spyren/Mecrisp-Cube/sdcard/man/img/calculator-header-150.jpg

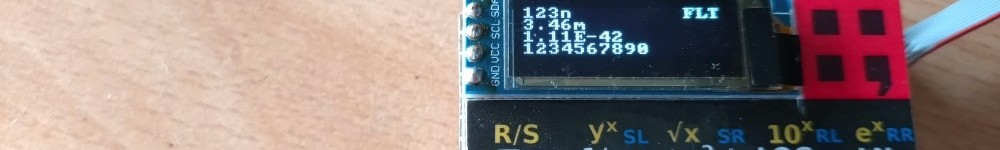
sdcard/man/img/calculator-header-150.jpg
