spyren/Mecrisp-Cube/sdcard/man/img/charger.jpg

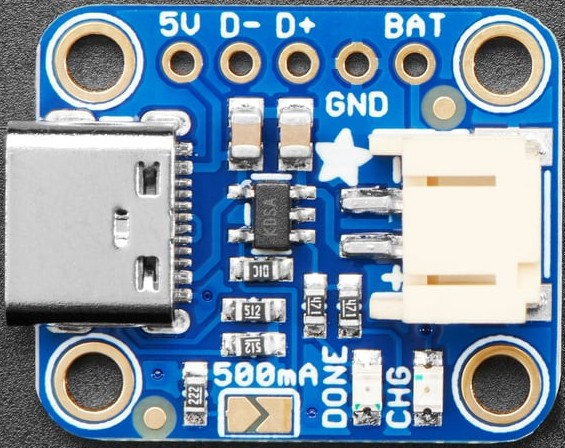
sdcard/man/img/charger.jpg
