spyren/Mecrisp-Cube/sdcard/man/img/display.jpg

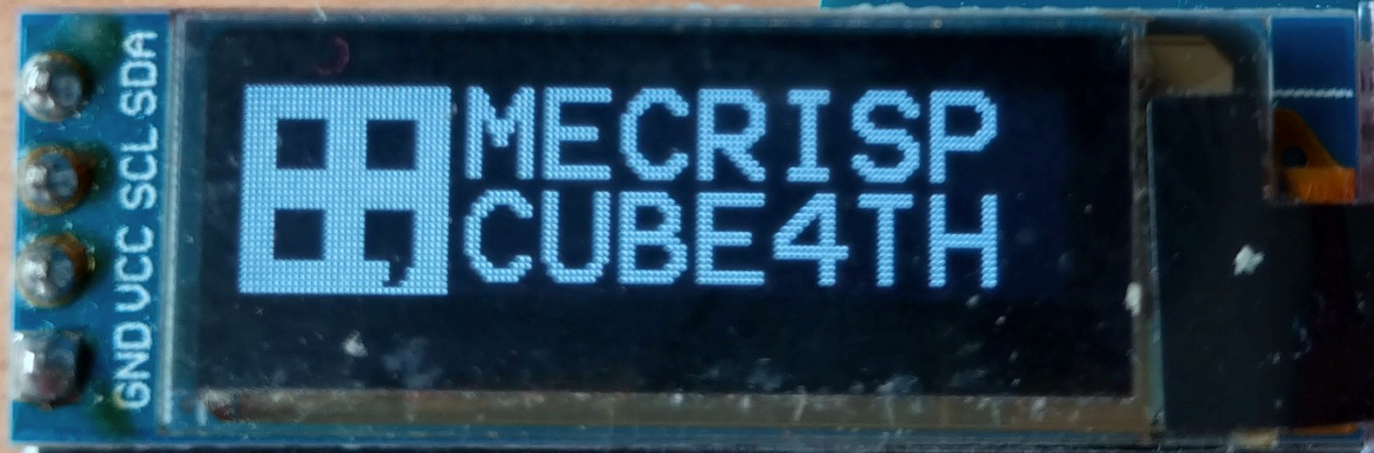
sdcard/man/img/display.jpg
