spyren/Mecrisp-Cube/sdcard/man/img/dongle.png

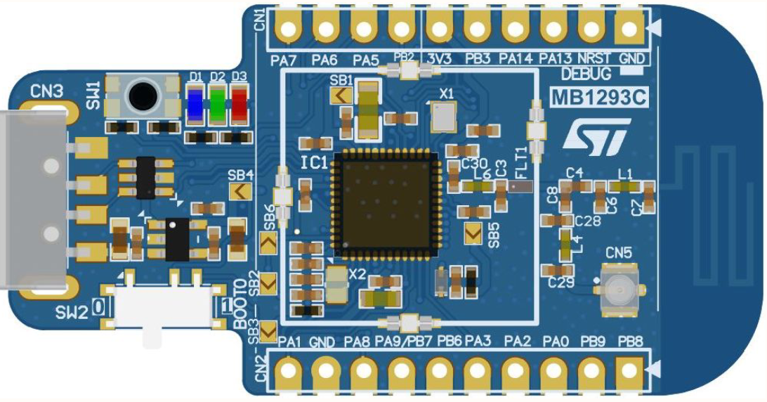
sdcard/man/img/dongle.png
