spyren/Mecrisp-Cube/sdcard/man/img/flipper-header.jpg

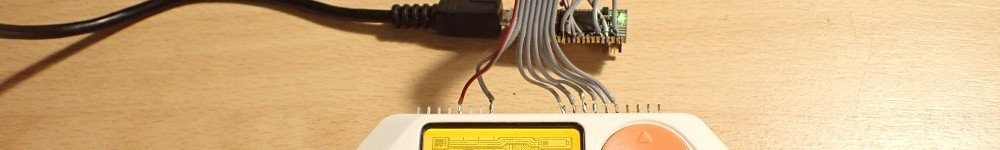
sdcard/man/img/flipper-header.jpg
