spyren/Mecrisp-Cube/sdcard/man/img/flipper-stlink-2.jpg

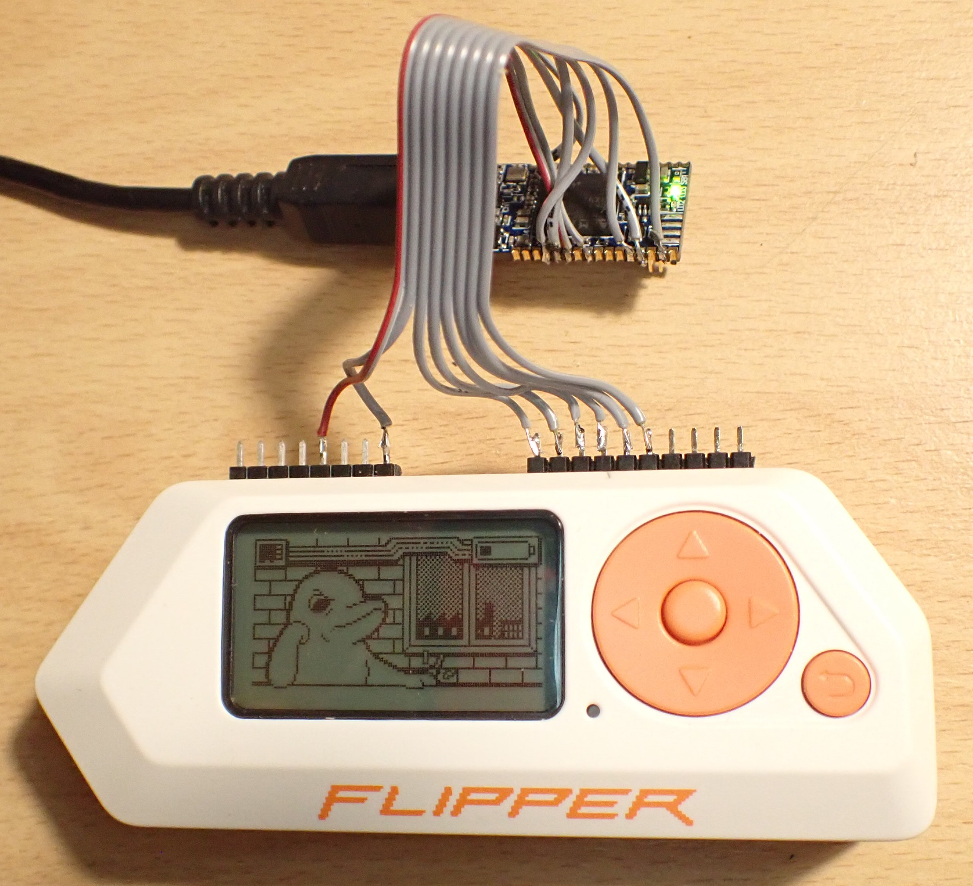
sdcard/man/img/flipper-stlink-2.jpg
