spyren/Mecrisp-Cube/sdcard/man/img/flipper-stlink.jpg

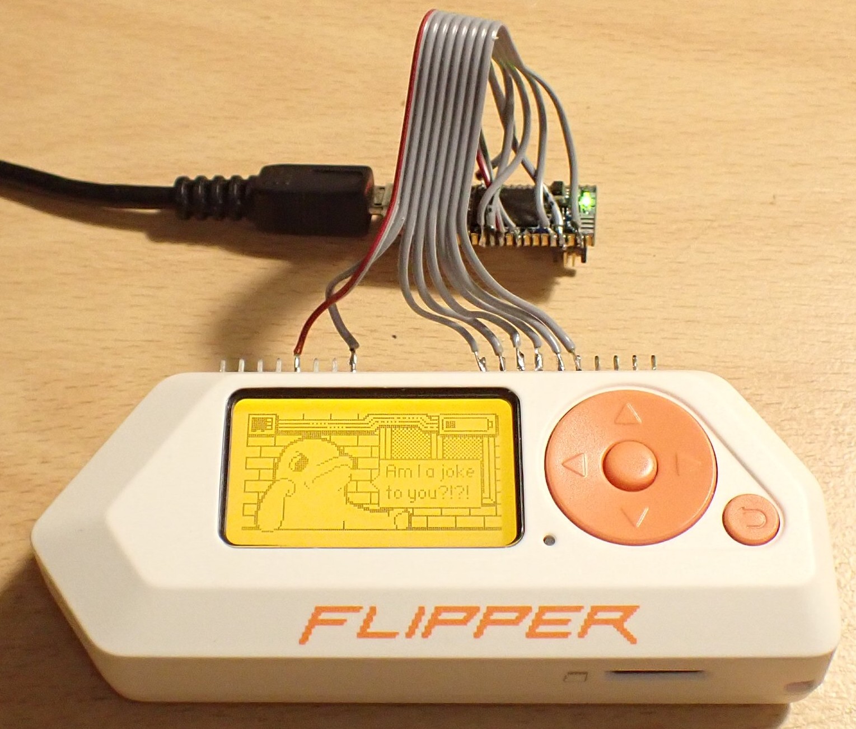
sdcard/man/img/flipper-stlink.jpg
