spyren/Mecrisp-Cube/sdcard/man/img/mecrisp-cube-f4.jpg

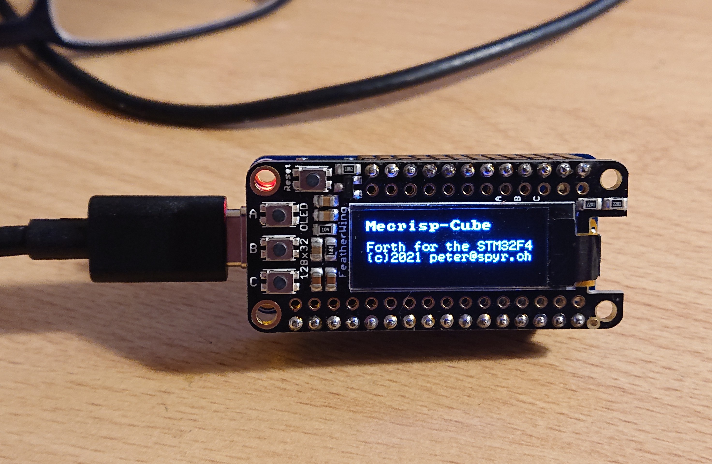
sdcard/man/img/mecrisp-cube-f4.jpg
