spyren/Mecrisp-Cube/sdcard/man/img/security.png

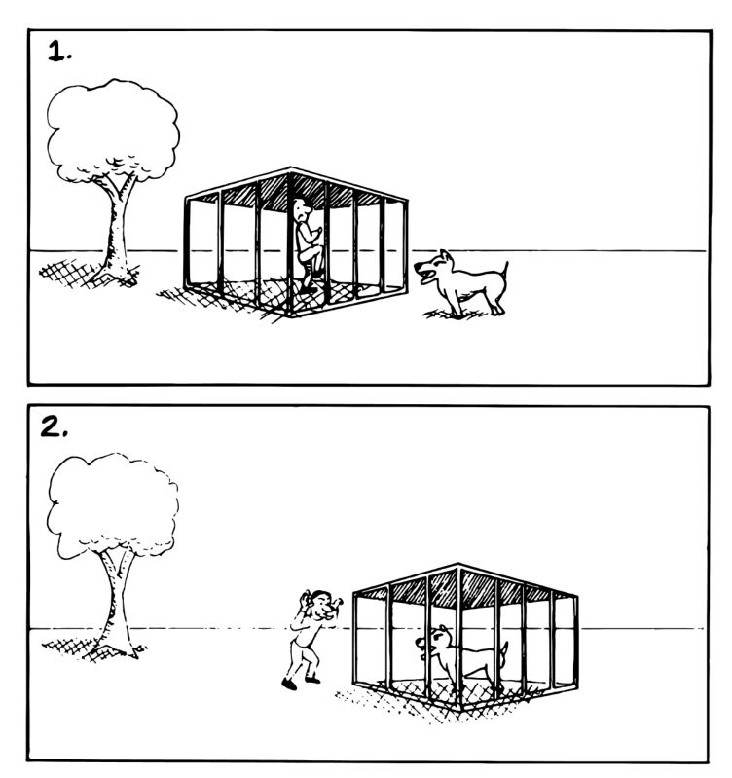
sdcard/man/img/security.png
