spyren/Mecrisp-Cube/sdcard/man/kicad/kicad.kicad_sch

## KiCad design sdcard/man/kicad/kicad.kicad_sch (2024-06-25)

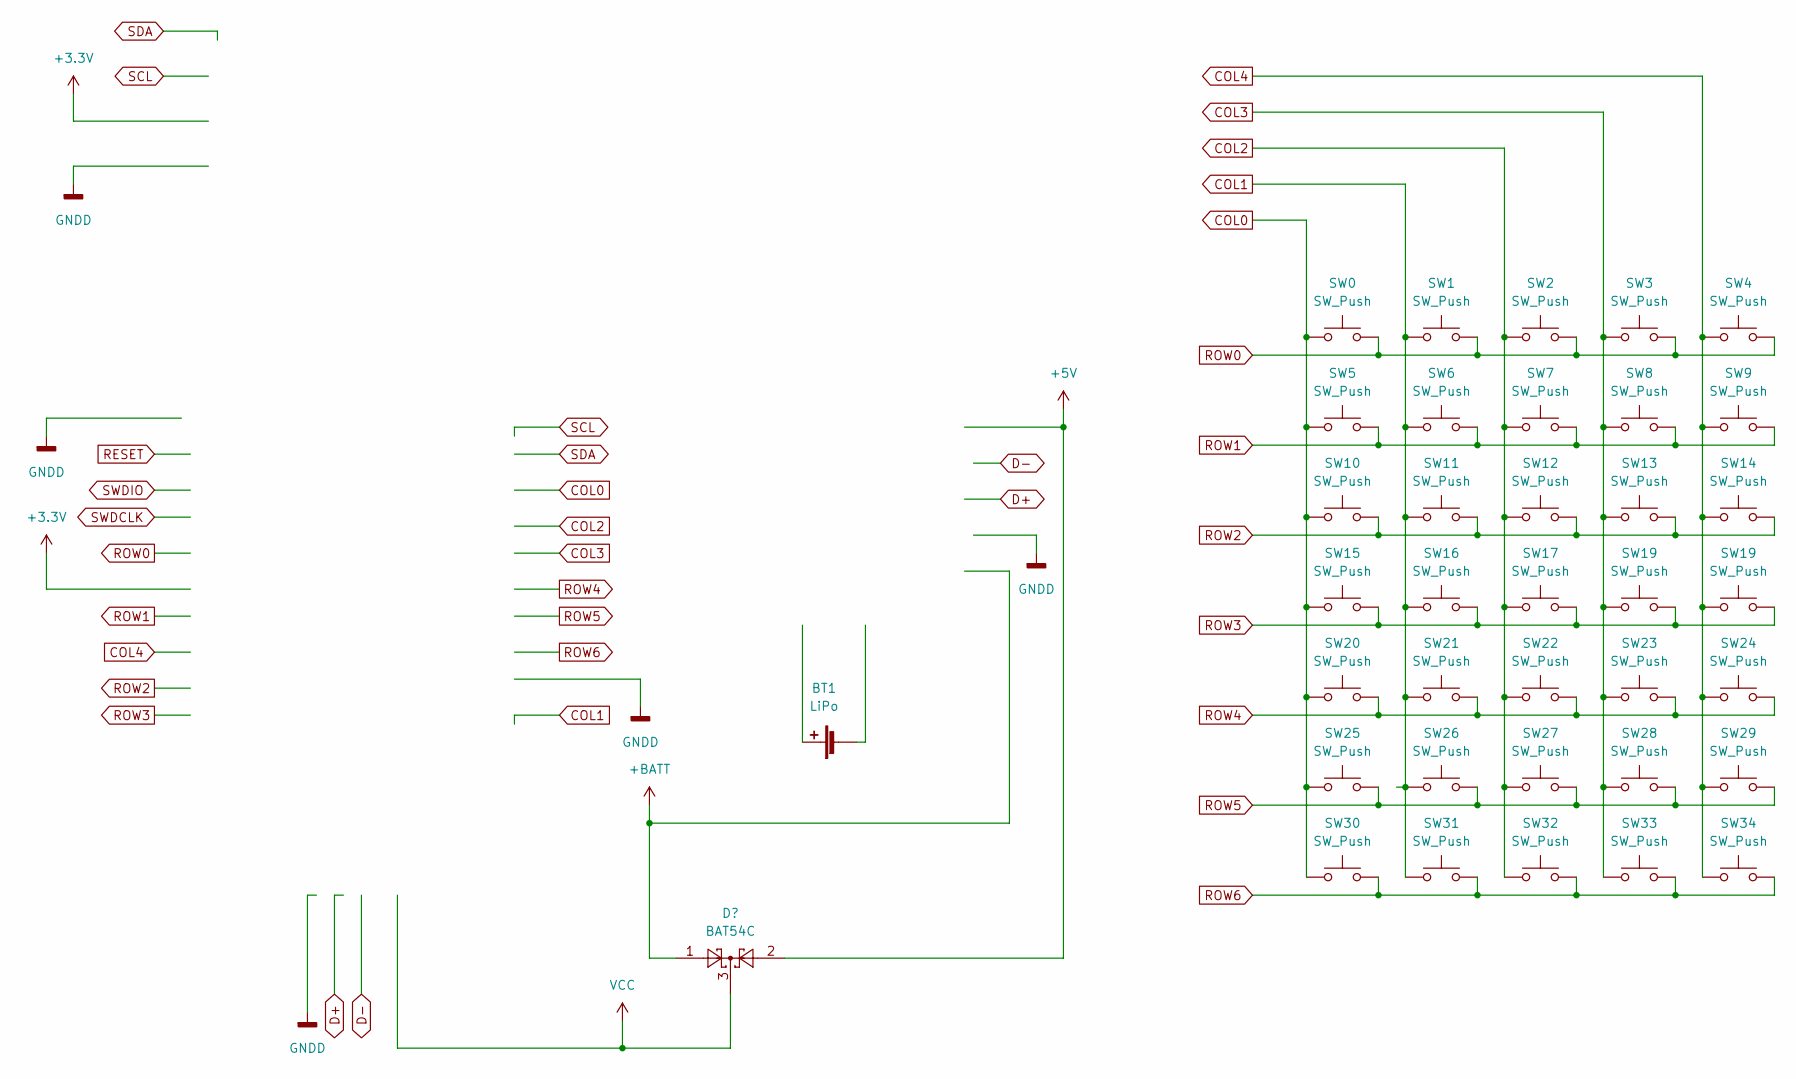
[picture p48: schematic kicad.kicad_sch]

Parts:
BT1: LiPo
SW0, SW1, SW2, SW3, SW4, SW5, SW6, SW7, SW8, SW9, SW10, SW11, SW12, SW13, SW14, SW15, SW16, SW17, SW19, SW20, SW21, SW22, SW23, SW24, SW25, SW26, SW27, SW28, SW29, SW30, SW31, SW32, SW33, SW34: SW_Push

Connections:
COL0: SW0.1, SW5.1, SW10.1, SW15.1, SW20.1, SW25.1, SW30.1
COL1: SW1.1, SW6.1, SW11.1, SW16.1, SW21.1, SW26.1, SW31.1
COL2: SW2.1, SW7.1, SW12.1, SW17.1, SW22.1, SW27.1, SW32.1
COL3: SW3.1, SW8.1, SW13.1, SW19.1, SW23.1, SW28.1, SW33.1
COL4: SW4.1, SW9.1, SW14.1, SW19.1, SW24.1, SW29.1, SW34.1
ROW0: SW0.2, SW1.2, SW2.2, SW3.2, SW4.2
ROW1: SW5.2, SW6.2, SW7.2, SW8.2, SW9.2
ROW2: SW10.2, SW11.2, SW12.2, SW13.2, SW14.2
ROW3: SW15.2, SW16.2, SW17.2, SW19.2
ROW4: SW20.2, SW21.2, SW22.2, SW23.2, SW24.2
ROW5: SW25.2, SW26.2, SW27.2, SW28.2, SW29.2
ROW6: SW30.2, SW31.2, SW32.2, SW33.2, SW34.2
