spyren/Mecrisp-Cube/MecrispCube.ioc

Mcu.UserName=STM32WB55RGVx
PA0.GPIO_Label=A3
PA0.Signal=SharedAnalog_PA0
PA1.GPIO_Label=A2
PA1.Signal=S_TIM2_CH2
PA10.GPIO_Label=D3
PA10.Signal=S_TIM1_CH3
PA11.Signal=USB_DM
PA12.Signal=USB_DP
PA13.GPIO_Label=JTMS
PA13.Signal=SYS_JTMS-SWDIO
PA14.GPIO_Label=JTCK
PA14.Signal=SYS_JTCK-SWCLK
PA15.GPIO_Label=D5
PA15.Signal=S_TIM2_CH1
PA2.GPIO_Label=D1
PA2.Signal=S_TIM2_CH3
PA3.GPIO_Label=D0
PA3.Signal=S_TIM2_CH4
PA4.GPIO_Label=D10
PA4.Signal=SharedStack_PA4
PA5.GPIO_Label=D13
PA5.Signal=SPI1_SCK
PA6.GPIO_Label=D12
PA6.Signal=SPI1_MISO
PA7.GPIO_Label=D11
PA7.Signal=SPI1_MOSI
PA8.GPIO_Label=D6
PA8.Signal=S_TIM1_CH1
PA9.GPIO_Label=D9
PA9.Signal=S_TIM1_CH2
PB0.GPIO_Label=LD2 [Green Led]
PB0.Signal=GPIO_Output
PB1.GPIO_Label=LD3 [Red Led]
PB1.Signal=GPIO_Output
PB2.GPIO_Label=DONGLE_SPI_CS
PB2.Signal=GPIO_Output
PB3.GPIO_Label=JTDO
PB3.Signal=SYS_JTDO-SWO
PB5.GPIO_Label=LD1 [Blue Led]
PB5.Signal=GPIO_Output
PB6.GPIO_Label=STLINK_RX
PB6.Signal=USART1_TX
PB7.GPIO_Label=STLINK_TX
PB7.Signal=USART1_RX
PB8.GPIO_Label=D15
PB8.Signal=SharedStack_PB8
PB9.GPIO_Label=D14
PB9.Signal=SharedStack_PB9
PC0.GPIO_Label=A0
PC0.Signal=SharedAnalog_PC0
PC1.GPIO_Label=A1
PC1.Signal=SharedAnalog_PC1
PC10.GPIO_Label=D4
PC10.Signal=SharedStack_PC10
PC12.GPIO_Label=D8
PC12.Signal=GPIO_Input
PC13.GPIO_Label=D7
PC13.Signal=SharedStack_PC13
PC14-OSC32_IN.Signal=RCC_OSC32_IN
PC15-OSC32_OUT.Signal=RCC_OSC32_OUT
PC2.GPIO_Label=A5
PC2.Signal=SharedAnalog_PC2
PC3.GPIO_Label=A4
PC3.Signal=SharedAnalog_PC3
PC4.GPIO_Label=B1 [Push Button]
PC4.Signal=GPIO_Input
PC6.GPIO_Label=D2
PC6.Signal=SharedStack_PC6
PD0.GPIO_Label=B2 [Push Button]
PD0.Signal=GPIO_Input
PD1.GPIO_Label=B3 [Push Button]
PD1.Signal=GPIO_Input
