spyren/Mecrisp-Cube/Core/Src/stm32wbxx_it.c

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

/* Includes ------------------------------------------------------------------*/
#include "main.h"
#include "stm32wbxx_it.h"
/* USER CODE BEGIN Includes */
#include "myassert.h"
/* USER CODE END Includes */

/* External variables --------------------------------------------------------*/
extern ADC_HandleTypeDef hadc1;
extern DMA_HandleTypeDef hdma_i2c1_rx;
extern DMA_HandleTypeDef hdma_i2c1_tx;
extern I2C_HandleTypeDef hi2c1;
extern IPCC_HandleTypeDef hipcc;
extern RTC_HandleTypeDef hrtc;
extern DMA_HandleTypeDef hdma_spi1_rx;
extern DMA_HandleTypeDef hdma_spi1_tx;
extern SPI_HandleTypeDef hspi1;
extern TIM_HandleTypeDef htim1;
extern TIM_HandleTypeDef htim2;
extern UART_HandleTypeDef huart1;
extern WWDG_HandleTypeDef hwwdg;
extern TIM_HandleTypeDef htim17;

/******************************************************************************/
/*           Cortex Processor Interruption and Exception Handlers          */
/******************************************************************************/
/**
  * @brief This function handles Non maskable interrupt.
  */
void NMI_Handler(void)
{
  /* USER CODE BEGIN NonMaskableInt_IRQn 0 */
	  while (1) {

	  }

  /* USER CODE END NonMaskableInt_IRQn 0 */
}

/**
  * @brief This function handles Hard fault interrupt.
  */
void HardFault_Handler(void)
{
  /* USER CODE BEGIN HardFault_IRQn 0 */
/*
    __asm volatile
    (
        " tst lr, #4                                                \n"
        " ite eq                                                    \n"
        " mrseq r0, msp                                             \n"
        " mrsne r0, psp                                             \n"
        " ldr r1, [r0, #24]                                         \n"
        " ldr r2, handler2_address_const                            \n"
        " bx r2                                                     \n"
        " handler2_address_const: .word prvGetRegistersFromStack    \n"
    );
*/

	// christmas tree
	HAL_GPIO_WritePin(LD3_GPIO_Port, LD1_Pin, GPIO_PIN_SET);
	HAL_GPIO_WritePin(LD3_GPIO_Port, LD2_Pin, GPIO_PIN_SET);
	HAL_GPIO_WritePin(LD3_GPIO_Port, LD3_Pin, GPIO_PIN_SET);

	ASSERT_fatal(0, ASSERT_HARD_FAULT, SCB->CFSR);
  /* USER CODE END HardFault_IRQn 0 */
  while (1)
  {
  }
}

/**
  * @brief This function handles Memory management fault.
  */
void MemManage_Handler(void)
{
  /* USER CODE BEGIN MemoryManagement_IRQn 0 */
	ASSERT_fatal(0, ASSERT_MEM_MANAGE_FAULT, SCB->CFSR);

  /* USER CODE END MemoryManagement_IRQn 0 */
  while (1)
  {
  }
}

/**
  * @brief This function handles Prefetch fault, memory access fault.
  */
void BusFault_Handler(void)
{
  /* USER CODE BEGIN BusFault_IRQn 0 */
	ASSERT_fatal(0, ASSERT_BUS_FAULT, SCB->CFSR);

  /* USER CODE END BusFault_IRQn 0 */
  while (1)
  {
  }
}

/**
  * @brief This function handles Undefined instruction or illegal state.
  */
void UsageFault_Handler(void)
{
  /* USER CODE BEGIN UsageFault_IRQn 0 */

	/* Configurable Fault Status Registers */
	ASSERT_fatal(0, ASSERT_USAGE_FAULT, SCB->CFSR);

  /* USER CODE END UsageFault_IRQn 0 */
  while (1)
  {
  }
}

/**
  * @brief This function handles Debug monitor.
  */
void DebugMon_Handler(void)
{
}

/******************************************************************************/
/* STM32WBxx Peripheral Interrupt Handlers                                    */
/* Add here the Interrupt Handlers for the used peripherals.                  */
/* For the available peripheral interrupt handler names,                      */
/* please refer to the startup file (startup_stm32wbxx.s).                    */
/******************************************************************************/

/**
  * @brief This function handles Window watchdog interrupt.
  */
void WWDG_IRQHandler(void)
{
  HAL_WWDG_IRQHandler(&hwwdg);
}

/**
  * @brief This function handles RTC wake-up interrupt through EXTI line 19.
  */
void RTC_WKUP_IRQHandler(void)
{
  /* USER CODE BEGIN RTC_WKUP_IRQn 0 */
  HW_TS_RTC_Wakeup_Handler();
  /* USER CODE END RTC_WKUP_IRQn 0 */
  HAL_RTCEx_WakeUpTimerIRQHandler(&hrtc);
}

/**
  * @brief This function handles Flash global interrupt.
  */
void FLASH_IRQHandler(void)
{
  HAL_FLASH_IRQHandler();
}

#if BUTTON == 1
/**
  * @brief This function handles EXTI line0 interrupt.
  */
void EXTI0_IRQHandler(void)
{
  HAL_GPIO_EXTI_IRQHandler(GPIO_PIN_0);
}

/**
  * @brief This function handles EXTI line1 interrupt.
  */
void EXTI1_IRQHandler(void)
{
  HAL_GPIO_EXTI_IRQHandler(GPIO_PIN_1);
}

/**
  * @brief This function handles EXTI line2 interrupt.
  */
void EXTI2_IRQHandler(void)
{
  HAL_GPIO_EXTI_IRQHandler(GPIO_PIN_2);
}

/**
  * @brief This function handles EXTI line3 interrupt.
  */
void EXTI3_IRQHandler(void)
{
  HAL_GPIO_EXTI_IRQHandler(GPIO_PIN_3);
}
#endif

/**
  * @brief This function handles EXTI line4 interrupt.
  */
void EXTI4_IRQHandler(void)
{
  HAL_GPIO_EXTI_IRQHandler(GPIO_PIN_4);
}

/**
  * @brief This function handles EXTI line[9:5] interrupts.
  */
void EXTI9_5_IRQHandler(void)
{
#if BUTTON == 1
  HAL_GPIO_EXTI_IRQHandler(GPIO_PIN_5);
#else
  HAL_GPIO_EXTI_IRQHandler(GPIO_PIN_6);
#endif
}

/**
  * @brief This function handles DMA1 channel1 global interrupt.
  */
void DMA1_Channel1_IRQHandler(void)
{
  HAL_DMA_IRQHandler(&hdma_spi1_rx);
}

/**
  * @brief This function handles DMA1 channel2 global interrupt.
  */
void DMA1_Channel2_IRQHandler(void)
{
  HAL_DMA_IRQHandler(&hdma_spi1_tx);
}

/**
  * @brief This function handles DMA1 channel3 global interrupt.
  */
void DMA1_Channel3_IRQHandler(void)
{
  HAL_DMA_IRQHandler(&hdma_i2c1_rx);
}

/**
  * @brief This function handles DMA1 channel4 global interrupt.
  */
void DMA1_Channel4_IRQHandler(void)
{
  HAL_DMA_IRQHandler(&hdma_i2c1_tx);
}

/**
  * @brief This function handles ADC1 global interrupt.
  */
void ADC1_IRQHandler(void)
{
  HAL_ADC_IRQHandler(&hadc1);
}

/**
  * @brief This function handles TIM1 trigger and commutation interrupts and TIM17 global interrupt.
  */
void TIM1_TRG_COM_TIM17_IRQHandler(void)
{
  HAL_TIM_IRQHandler(&htim1);
  HAL_TIM_IRQHandler(&htim17);
}

/**
  * @brief This function handles TIM2 global interrupt.
  */
void TIM2_IRQHandler(void)
{
  HAL_TIM_IRQHandler(&htim2);
}

/**
  * @brief This function handles I2C1 event interrupt.
  */
void I2C1_EV_IRQHandler(void)
{
  HAL_I2C_EV_IRQHandler(&hi2c1);
}

/**
  * @brief This function handles I2C1 error interrupt.
  */
void I2C1_ER_IRQHandler(void)
{
  HAL_I2C_ER_IRQHandler(&hi2c1);
}

/**
  * @brief This function handles SPI1 global interrupt.
  */
void SPI1_IRQHandler(void)
{
  HAL_SPI_IRQHandler(&hspi1);
}

/**
  * @brief This function handles USART1 global interrupt.
  */
void USART1_IRQHandler(void)
{
  HAL_UART_IRQHandler(&huart1);
}

/**
  * @brief This function handles EXTI line[15:10] interrupts.
  */
void EXTI15_10_IRQHandler(void)
{
  HAL_GPIO_EXTI_IRQHandler(GPIO_PIN_10);
  HAL_GPIO_EXTI_IRQHandler(GPIO_PIN_13);
}

/**
  * @brief This function handles RTC A and B alarm interrupt through EXTI line 17.
  */
void RTC_Alarm_IRQHandler(void)
{
  HAL_RTC_AlarmIRQHandler(&hrtc);
}

/**
  * @brief This function handles IPCC RX occupied interrupt.
  */
void IPCC_C1_RX_IRQHandler(void)
{
  HAL_IPCC_RX_IRQHandler(&hipcc);
}

/**
  * @brief This function handles IPCC TX free interrupt.
  */
void IPCC_C1_TX_IRQHandler(void)
{
  HAL_IPCC_TX_IRQHandler(&hipcc);
}

/**
  * @brief This function handles HSEM global interrupt.
  */
void HSEM_IRQHandler(void)
{
  HAL_HSEM_IRQHandler();
}

/* USER CODE BEGIN 1 */

/*
void prvGetRegistersFromStack( uint32_t *pulFaultStackAddress )
{
// These are volatile to try and prevent the compiler/linker optimising them
//away as the variables never actually get used.  If the debugger won't show the
//values of the variables, make them global my moving their declaration outside
//of this function.
volatile uint32_t r0;
volatile uint32_t r1;
volatile uint32_t r2;
volatile uint32_t r3;
volatile uint32_t r12;
volatile uint32_t lr; // Link register.
volatile uint32_t pc; // Program counter.
volatile uint32_t psr;// Program status register.

    r0 = pulFaultStackAddress[ 0 ];
    r1 = pulFaultStackAddress[ 1 ];
    r2 = pulFaultStackAddress[ 2 ];
    r3 = pulFaultStackAddress[ 3 ];

    r12 = pulFaultStackAddress[ 4 ];
    lr = pulFaultStackAddress[ 5 ];
    pc = pulFaultStackAddress[ 6 ];
    psr = pulFaultStackAddress[ 7 ];

    // When the following line is hit, the variables contain the register values.
    for( ;; );
}
*/

/* USER CODE END 1 */
