spyren/Mecrisp-Cube/Forth/Inc/12x16_vertikal_LSB_1.h

/*
 * 8x16_vertikal_LSB_1.h
 *
 *  Created on: 02.01.2021
 *      Author: psi
 */

#ifndef INC_12X16_H_
#define INC_12X16_H_

const char font_12x16[256][24]={
		{0x00,0x00,0x00,0x00,0x00,0x00,0x00,0x00,0x00,0x00,0x00,0x00,0x00,0x00,0x00,0x00,0x00,0x00,0x00,0x00,0x00,0x00,0x00,0x00},	// 0x00
		{0x00,0x00,0xF0,0x03,0x0C,0x0C,0x02,0x10,0x32,0x11,0x31,0x22,0x01,0x22,0x31,0x22,0x32,0x11,0x02,0x10,0x0C,0x0C,0xF0,0x03},	// 0x01
		{0x00,0x00,0xF0,0x03,0xFC,0x0F,0xFE,0x1F,0xCE,0x1E,0xCF,0x3D,0xFF,0x3D,0xCF,0x3D,0xCE,0x1E,0xFE,0x1F,0xFC,0x0F,0xF0,0x03},	// 0x02
		{0x00,0x00,0x00,0x00,0xF0,0x00,0xF8,0x01,0xF8,0x03,0xF0,0x07,0xE0,0x0F,0xF0,0x07,0xF8,0x03,0xF8,0x01,0xF0,0x00,0x00,0x00},	// 0x03
		{0x00,0x00,0x00,0x00,0x80,0x00,0xC0,0x01,0xE0,0x03,0xF0,0x07,0xF8,0x0F,0xF0,0x07,0xE0,0x03,0xC0,0x01,0x80,0x00,0x00,0x00},	// 0x04
		{0x00,0x00,0x80,0x03,0xC0,0x07,0xC0,0x07,0xB8,0x13,0xFC,0x1B,0xFC,0x1F,0xFC,0x1B,0xB8,0x13,0xC0,0x07,0xC0,0x07,0x80,0x03},	// 0x05
		{0x00,0x00,0x00,0x00,0x80,0x03,0xC0,0x07,0xE0,0x17,0xF0,0x1B,0xFC,0x1F,0xF0,0x1B,0xE0,0x17,0xC0,0x07,0x80,0x03,0x00,0x00},	// 0x06
		{0x00,0x00,0x00,0x00,0x00,0x00,0x00,0x00,0x00,0x00,0x00,0x00,0x00,0x00,0x00,0x00,0x00,0x00,0x00,0x00,0x00,0x00,0x00,0x00},	// 0x07
		{0x00,0x00,0x00,0x00,0x00,0x00,0x00,0x00,0x00,0x00,0x00,0x00,0x00,0x00,0x00,0x00,0x00,0x00,0x00,0x00,0x00,0x00,0x00,0x00},	// 0x08
		{0x00,0x00,0x00,0x00,0x00,0x00,0x00,0x00,0x00,0x00,0x00,0x00,0x00,0x00,0x00,0x00,0x00,0x00,0x00,0x00,0x00,0x00,0x00,0x00},	// 0x09
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
		{0x00,0x00,0x00,0x00,0x00,0x00,0x00,0x00,0x27,0x00,0x3F,0x00,0x1F,0x00,0x00,0x00,0x00,0x00,0x00,0x00,0x00,0x00,0x00,0x00},	// 0x27
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
		};

#endif /* INC_12X16_H_ */
