spyren/Mecrisp-Cube/Forth/Inc/8x8_vertikal_LSB_1.h

/*
 * 8x8_vertikal_LSB_1.h
 *
 *  Created on: 02.01.2021
 *      Author: psi
 */

#ifndef INC_8X8_H_
#define INC_8X8_H_

const char font_8x8[256][8]={
		{0x00,0x00,0x00,0x00,0x00,0x00,0x00,0x00},	// 0x00
		{0x7E,0x81,0x95,0xB1,0xB1,0x95,0x81,0x7E},	// 0x01
		{0x7E,0xFF,0xEB,0xCF,0xCF,0xEB,0xFF,0x7E},	// 0x02
		{0x0E,0x1F,0x3F,0x7E,0x3F,0x1F,0x0E,0x00},	// 0x03
		{0x08,0x1C,0x3E,0x7F,0x3E,0x1C,0x08,0x00},	// 0x04
		{0x38,0x3A,0x9F,0xFF,0x9F,0x3A,0x38,0x00},	// 0x05
		{0x10,0x38,0xBC,0xFF,0xBC,0x38,0x10,0x00},	// 0x06
		{0x00,0x00,0x00,0x00,0x00,0x00,0x00,0x00},	// 0x07
		{0x00,0x00,0x00,0x00,0x00,0x00,0x00,0x00},	// 0x08
		{0x00,0x00,0x00,0x00,0x00,0x00,0x00,0x00},	// 0x09
		{0x00,0x00,0x00,0x00,0x00,0x00,0x00,0x00},	// 0x0A
		{0x70,0xF8,0x88,0x88,0xFD,0x7F,0x07,0x0F},	// 0x0B
		{0x00,0x4E,0x5F,0xF1,0xF1,0x5F,0x4E,0x00},	// 0x0C
		{0x00,0x00,0x00,0x00,0x00,0x00,0x00,0x00},	// 0x0D
		{0xC0,0xFF,0x7F,0x05,0x05,0x65,0x7F,0x3F},	// 0x0E
		{0x99,0x5A,0x3C,0xE7,0xE7,0x3C,0x5A,0x99},	// 0x0F
		{0x7F,0x3E,0x3E,0x1C,0x1C,0x08,0x08,0x00},	// 0x10
		{0x08,0x08,0x1C,0x1C,0x3E,0x3E,0x7F,0x00},	// 0x11
		{0x00,0x24,0x66,0xFF,0xFF,0x66,0x24,0x00},	// 0x12
		{0x00,0x5F,0x5F,0x00,0x00,0x5F,0x5F,0x00},	// 0x13
		{0x06,0x0F,0x09,0x7F,0x7F,0x01,0x7F,0x7F},	// 0x14
		{0xDA,0xBF,0xA5,0xA5,0xFD,0x59,0x03,0x02},	// 0x15
		{0x00,0x70,0x70,0x70,0x70,0x70,0x70,0x00},	// 0x16
		{0x80,0x94,0xB6,0xFF,0xFF,0xB6,0x94,0x80},	// 0x17
		{0x00,0x04,0x06,0x7F,0x7F,0x06,0x04,0x00},	// 0x18
		{0x00,0x10,0x30,0x7F,0x7F,0x30,0x10,0x00},	// 0x19
		{0x08,0x08,0x08,0x2A,0x3E,0x1C,0x08,0x00},	// 0x1A
		{0x08,0x1C,0x3E,0x2A,0x08,0x08,0x08,0x00},	// 0x1B
		{0x3C,0x3C,0x20,0x20,0x20,0x20,0x20,0x00},	// 0x1C
		{0x08,0x1C,0x3E,0x08,0x08,0x3E,0x1C,0x08},	// 0x1D
		{0x30,0x38,0x3C,0x3E,0x3E,0x3C,0x38,0x30},	// 0x1E
		{0x06,0x0E,0x1E,0x3E,0x3E,0x1E,0x0E,0x06},	// 0x1F
		{0x00,0x00,0x00,0x00,0x00,0x00,0x00,0x00},	// 0x20
		{0x00,0x06,0x5F,0x5F,0x06,0x00,0x00,0x00},	// 0x21
		{0x00,0x07,0x07,0x00,0x07,0x07,0x00,0x00},	// 0x22
		{0x14,0x7F,0x7F,0x14,0x7F,0x7F,0x14,0x00},	// 0x23
		{0x24,0x2E,0x6B,0x6B,0x3A,0x12,0x00,0x00},	// 0x24
		{0x46,0x66,0x30,0x18,0x0C,0x66,0x62,0x00},	// 0x25
		{0x30,0x7A,0x4F,0x5D,0x37,0x7A,0x48,0x00},	// 0x26
		{0x04,0x07,0x03,0x00,0x00,0x00,0x00,0x00},	// 0x27
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
		};

#endif /* INC_8X8_H_ */
