spyren/Mecrisp-Cube/tinyusb/bsp/family.c

/*
 * The MIT License (MIT)
 *
 * Copyright (c) 2022 Jerzy Kasenberg
 *
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
 * This file is part of the TinyUSB stack.
 */

#include "stm32wbxx_hal.h"
#include "bsp/board_api.h"
#include "board.h"
#include "stm32_lpm.h"

//--------------------------------------------------------------------+
// Forward USB interrupt events to TinyUSB IRQ Handler
//--------------------------------------------------------------------+
void USB_HP_IRQHandler(void)
{
  UTIL_LPM_SetStopMode(1U << CFG_LPM_USB, UTIL_LPM_DISABLE);
  tud_int_handler(0);
}

void USB_LP_IRQHandler(void)
{
  UTIL_LPM_SetStopMode(1U << CFG_LPM_USB, UTIL_LPM_DISABLE);
  tud_int_handler(0);
}

//--------------------------------------------------------------------+
// MACRO TYPEDEF CONSTANT ENUM
//--------------------------------------------------------------------+
UART_HandleTypeDef UartHandle;

void board_init(void)
{
	// see main.c
//  board_clock_init();

  // Enable All GPIOs clocks
  __HAL_RCC_GPIOA_CLK_ENABLE();
  __HAL_RCC_GPIOB_CLK_ENABLE();
  __HAL_RCC_GPIOC_CLK_ENABLE();
  __HAL_RCC_GPIOD_CLK_ENABLE();
  __HAL_RCC_GPIOE_CLK_ENABLE();

  UART_CLK_EN();

#if CFG_TUSB_OS == OPT_OS_NONE
  // 1ms tick timer
  SysTick_Config(SystemCoreClock / 1000);
#elif CFG_TUSB_OS == OPT_OS_FREERTOS
  // Explicitly disable systick to prevent its ISR runs before scheduler start
//  SysTick->CTRL &= ~1U;

  // If freeRTOS is used, IRQ priority is limit by max syscall ( smaller is higher )
  NVIC_SetPriority(USB_HP_IRQn, configLIBRARY_MAX_SYSCALL_INTERRUPT_PRIORITY);
  NVIC_SetPriority(USB_LP_IRQn, configLIBRARY_MAX_SYSCALL_INTERRUPT_PRIORITY);
#endif


  GPIO_InitTypeDef  GPIO_InitStruct;

#if 0
  // LED
  GPIO_InitStruct.Pin = LED_PIN;
  GPIO_InitStruct.Mode = GPIO_MODE_OUTPUT_PP;
  GPIO_InitStruct.Pull = GPIO_NOPULL;
  GPIO_InitStruct.Speed = GPIO_SPEED_FREQ_HIGH;
  HAL_GPIO_Init(LED_PORT, &GPIO_InitStruct);

#if 0
  // MCO configuration for System clock value verification PA8 will have SYSCLK / 2
  GPIO_InitStruct.Pin = 8;
  GPIO_InitStruct.Mode = GPIO_MODE_OUTPUT_PP;
  GPIO_InitStruct.Pull = GPIO_NOPULL;
  GPIO_InitStruct.Speed = GPIO_SPEED_FREQ_HIGH;
  GPIO_InitStruct.Alternate = GPIO_AF0_MCO;
  HAL_GPIO_Init(GPIOA, &GPIO_InitStruct);
  HAL_RCC_MCOConfig(RCC_MCO1, RCC_MCO1SOURCE_SYSCLK, RCC_MCODIV_2);
#endif

//  board_led_write(false);

  // Button
  GPIO_InitStruct.Pin = BUTTON_PIN;
  GPIO_InitStruct.Mode = GPIO_MODE_INPUT;
  GPIO_InitStruct.Pull = BUTTON_STATE_ACTIVE ? GPIO_PULLDOWN : GPIO_PULLUP;
  GPIO_InitStruct.Speed = GPIO_SPEED_FREQ_HIGH;
  HAL_GPIO_Init(BUTTON_PORT, &GPIO_InitStruct);

#ifdef UART_DEV
  // UART
  GPIO_InitStruct.Pin       = UART_TX_PIN | UART_RX_PIN;
  GPIO_InitStruct.Mode      = GPIO_MODE_AF_PP;
  GPIO_InitStruct.Pull      = GPIO_PULLUP;
  GPIO_InitStruct.Speed     = GPIO_SPEED_FREQ_HIGH;
  GPIO_InitStruct.Alternate = UART_GPIO_AF;
  HAL_GPIO_Init(UART_GPIO_PORT, &GPIO_InitStruct);

  UartHandle = (UART_HandleTypeDef){
    .Instance        = UART_DEV,
    .Init.BaudRate   = CFG_BOARD_UART_BAUDRATE,
    .Init.WordLength = UART_WORDLENGTH_8B,
    .Init.StopBits   = UART_STOPBITS_1,
    .Init.Parity     = UART_PARITY_NONE,
    .Init.HwFlowCtl  = UART_HWCONTROL_NONE,
    .Init.Mode       = UART_MODE_TX_RX,
    .Init.OverSampling = UART_OVERSAMPLING_16
  };
  HAL_UART_Init(&UartHandle);
#endif
#endif

  // USB Pins TODO double check USB clock and pin setup
  // Configure USB DM and DP pins. This is optional, and maintained only for user guidance.
  GPIO_InitStruct.Pin = (GPIO_PIN_11 | GPIO_PIN_12);
  GPIO_InitStruct.Mode = GPIO_MODE_INPUT;
  GPIO_InitStruct.Pull = GPIO_NOPULL;
  GPIO_InitStruct.Speed = GPIO_SPEED_FREQ_HIGH;
  HAL_GPIO_Init(GPIOA, &GPIO_InitStruct);

  HAL_PWREx_EnableVddUSB();
  __HAL_RCC_USB_CLK_ENABLE();
}

//--------------------------------------------------------------------+
// Board porting API
//--------------------------------------------------------------------+

#if 0
void board_led_write(bool state)
{
  HAL_GPIO_WritePin(LED_PORT, LED_PIN, state ? LED_STATE_ON : (1-LED_STATE_ON));
}

uint32_t board_button_read(void)
{
  return BUTTON_STATE_ACTIVE == HAL_GPIO_ReadPin(BUTTON_PORT, BUTTON_PIN);
}

int board_uart_read(uint8_t* buf, int len)
{
  (void) buf; (void) len;
  return 0;
}

int board_uart_write(void const * buf, int len)
{
#ifdef UART_DEV
  HAL_UART_Transmit(&UartHandle, (uint8_t*)(uintptr_t) buf, len, 0xffff);
  return len;
#else
  (void) buf; (void) len; (void) UartHandle;
  return 0;
#endif
}

#if CFG_TUSB_OS  == OPT_OS_NONE
volatile uint32_t system_ticks = 0;
void SysTick_Handler (void)
{
  HAL_IncTick();
  system_ticks++;
}

uint32_t board_millis(void)
{
  return system_ticks;
}
#endif
#endif


size_t board_get_unique_id(uint8_t id[], size_t max_len) {

	uint32_t uid[3]; // STM32 MCUs have 96 bit (12 bytes) UIDs
	uid[0] = HAL_GetUIDw0();
	uid[1] = HAL_GetUIDw1();
	uid[2] = HAL_GetUIDw2();

	int len; // Note max_len is typically 16
	if (max_len < 12) {
		len = max_len;
	} else {
		len = 12;
	}
	memcpy(id, uid, len);

	return len;
}
