spyren/Mecrisp-Cube/peripherals/fd.c

/**
 *  @brief
 *      Flash drive block read and write.
 *
 *      The internal flash from 0x08060000 to 0x080BFFFF (384 KiB) is used
 *      for the flash drive.
 *      API similar to sd card.
 *  @file
 *      fd.c
 *  @author
 *      Peter Schmid, peter@spyr.ch
 *  @date
 *      2020-10-27
 *  @remark
 *      Language: C, STM32CubeIDE GCC
 *  @copyright
 *      Peter Schmid, Switzerland
 *
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
 *      You should have received a copy of the GNU General Public License
 *      along with Mecrsip-Cube. If not, see http://www.gnu.org/licenses/.
 */

// System include files
// ********************
#include "cmsis_os.h"

// Application include files
// *************************
#include "app_common.h"
#include "main.h"
#include "fd.h"
#include "sd.h"
#include "flash.h"
#include "myassert.h"
#include "bsp.h"


// Defines
// *******
#define FLASH_DUMMY_BYTE		0xFF
#define	RAM_SHARED				SRAM2B_BASE	// SRAM2b is only used for Thread, 15 KiB


// Private function prototypes
// ***************************
static int flash_page(uint8_t *pData, uint32_t addr, uint16_t block_field);


// Global Variables
// ****************

// RTOS resources
// **************

static osMutexId_t FD_MutexID;
static const osMutexAttr_t FD_MutexAttr = {
		NULL,				// no name required
		osMutexPrioInherit,	// attr_bits
		NULL,				// memory for control block
		0U					// size for control block
};


// Hardware resources
// ******************


// Private Variables
// *****************


int FD_size = 0; // number of blocks

static uint8_t *scratch_page; 	// protected by FD_MutexID

// Public Functions
// ****************

/**
 *  @brief
 *      Initializes the flash drive.
 *  @return
 *      None
 */
void FD_init(void) {
	scratch_page = (uint8_t *) RAM_SHARED;
//	scratch_page = pvPortMalloc(FD_PAGE_SIZE);
	*scratch_page = 0xaa;
	FD_MutexID = osMutexNew(&FD_MutexAttr);
	ASSERT_fatal(FD_MutexID != NULL, ASSERT_MUTEX_CREATION, __get_PC());
}


/**
 *  @brief
 *      Initializes the flash drive and get the size in KiB.
 *  @return
 *      None
 */
void FD_getSize(void) {
	FD_size = (FD_END_ADDRESS - FD_START_ADDRESS) / 1024;
}

/**
 *  @brief
 *      Get the flash drive size in KiB.
 *  @return
 *      size in KiB
 */
int FD_getBlocks(void) {
	return FD_size;
}


/**
  * @brief
  *     Reads block(s) from a specified address from the flash drive.
  *
  * @param
  *     pData: Pointer to the buffer that will contain the data to transmit
  * @param
  *     ReadAddr: Address from where data is to be read. The address is counted
  *                   in blocks of 512bytes
  * @param
  *     NumOfBlocks: Number of FD blocks to read
  * @retval
  *     FD status
  */
uint8_t FD_ReadBlocks(uint8_t *pData, uint32_t ReadAddr, uint32_t NumOfBlocks) {
	uint8_t retr = SD_ERROR;

	BSP_setSysLED(SYSLED_DISK_READ_OPERATION);

	if (FD_START_ADDRESS + (ReadAddr+NumOfBlocks)*FD_BLOCK_SIZE <= FD_END_ADDRESS) {
		// valid blocks
		memcpy(pData, (uint8_t *) FD_START_ADDRESS + ReadAddr*FD_BLOCK_SIZE,
				NumOfBlocks*FD_BLOCK_SIZE);
		retr = SD_OK;
	}

	BSP_clearSysLED(SYSLED_DISK_READ_OPERATION);
	/* Return the reponse */
	return retr;
}


/**
  * @brief
  *     Writes block(s) to a specified address to the internal flash.
  *
  *     The flash is divided in 4 KiB pages. If any byte in the sectors is not
  *     0xFF the page where the sector belongs to has to be erased. The whole page
  *     has to be saved before.
  * @param
  *     pData: Pointer to the buffer that will contain the data to transmit
  * @param
  *     WriteAddr: Address from where data is to be written. The address is counted
  *                   in blocks of 512bytes
  * @param
  *     NumOfBlocks: Number of FD blocks to write
  * @retval
  *     FD status
  */
uint8_t FD_WriteBlocks(uint8_t *pData, uint32_t WriteAddr, uint32_t NumOfBlocks) {
	uint8_t retr = SD_ERROR;
	int i;
	uint8_t block_field; // bit0 block0, bit1 block1 ..

	BSP_setSysLED(SYSLED_DISK_WRITE_OPERATION);

	uint32_t base_block_adr = WriteAddr & (~ (FD_BLOCKS_PER_PAGE -1));

	if (FD_START_ADDRESS + (WriteAddr+NumOfBlocks)*FD_BLOCK_SIZE <= FD_END_ADDRESS) {
		// valid blocks

		osMutexAcquire(FD_MutexID, osWaitForever);

		int FirstBoundary = WriteAddr % FD_BLOCKS_PER_PAGE;
		int LastBoundary = (WriteAddr + NumOfBlocks) % FD_BLOCKS_PER_PAGE;
		int pages = NumOfBlocks / FD_BLOCKS_PER_PAGE;
		if (FirstBoundary + LastBoundary > 0) {
			pages++;
		}

		uint32_t base_flash_addr = FD_START_ADDRESS + base_block_adr * FD_BLOCK_SIZE;
		retr = SD_OK;
		for (i=0; i < pages; i++) {
			if (i==0 && i == pages -1) {
				// only one page
				if (LastBoundary == 0) {
					block_field = 0xFF << FirstBoundary;
				} else {
					block_field = (0xFF << FirstBoundary) & (0xFF >> (FD_BLOCKS_PER_PAGE - LastBoundary));
				}
			} else if (i==0) {
				// first page
				block_field = 0xFF << FirstBoundary;
			} else if (i == pages -1) {
				// last page
				if (LastBoundary == 0) {
					block_field = 0xFF;
				} else {
					block_field = 0xFF >> LastBoundary;
				}
			} else {
				block_field = 0xFF;
			}
			if (flash_page(
					pData +  i*FD_PAGE_SIZE, 			// dress data source (contiguous)
					base_flash_addr + i*FD_PAGE_SIZE,	// page base address flash dest
					block_field)						// valid blocks bitfield
					!= SD_OK) {
				retr = SD_ERROR;
				break;
			}
		}

		osMutexRelease(FD_MutexID);
	} else {
		retr = SD_ERROR;
	}

	BSP_clearSysLED(SYSLED_DISK_WRITE_OPERATION);
	/* Return the response */
	return retr;
}


/**
  * @brief
  *     Erase Drive
  *
  * @retval
  *     FD status
  */
uint8_t FD_eraseDrive(void) {
	uint8_t retr = SD_OK;
	uint32_t flash_addr;

	osMutexAcquire(FD_MutexID, osWaitForever);
	for (flash_addr = FD_START_ADDRESS; flash_addr<FD_END_ADDRESS; flash_addr += FD_PAGE_SIZE) {
		if (FLASH_erasePage(flash_addr) != HAL_OK) {
			retr = SD_ERROR;
			break;
		}
	}
	osMutexRelease(FD_MutexID);
	return retr;
}


// Private Functions
// *****************

/**
  * @brief
  *     Writes blocks to a flash page.
  *
  *     The 512 bytes blocks have to be contiguous and marked in a bitfield.
  * @param
  *     pData: Pointer to the buffer that will contain the data blocks
  * @param
  *     flash_addr: page address (4 KiB pages).
  * @param
  *     block_field: bit0 is block 0, bit1 is block 1 and so on. 8 blocks.
  * @retval
  *     FD status
  */static int flash_page(uint8_t *pData, uint32_t flash_addr, uint16_t block_field) {
	uint8_t retr = SD_OK;
	int i, j;
	uint8_t *byte_p;
	uint8_t erased = TRUE;

	// are the blocks in the page already erased?
	byte_p = (uint8_t *) flash_addr;
	for (i=0; i<FD_BLOCKS_PER_PAGE; i++) {
		if (block_field & (1 << i)) {
			// block belongs to page
			for (j=0; j<FD_BLOCK_SIZE; j++) {
				if (*(byte_p + j) != 0xFF) {
					erased = FALSE;
					break;
				}
			}
			if (!erased) {
				break;
			}
		}
		byte_p += FD_BLOCK_SIZE;
	}

	if (erased) {
		// flash erased
		// flash the blocks
		int k = 0;
		byte_p = (uint8_t *) flash_addr;
		for (i=0; i<FD_BLOCKS_PER_PAGE; i++) {
			if (block_field & (1 << i)) {
				// block belongs to page -> program
				for (j=0; j < FD_BLOCK_SIZE / FD_FLASH_RECORD; j++) {
					if (FLASH_programDouble(
							(uint32_t) byte_p,
							*(uint32_t *) (pData+k*FD_BLOCK_SIZE+j*FD_FLASH_RECORD),
							*(uint32_t *) (pData+k*FD_BLOCK_SIZE+j*FD_FLASH_RECORD+4) )
							!= HAL_OK) {
						retr = SD_ERROR;
						break;
					}
					byte_p += 8;
				}
				k++;
				if (retr != SD_OK) {
					break;
				}
			} else {
				// block doesn't belong to the page -> skip
				byte_p += FD_BLOCK_SIZE;
			}
		}
	} else {
		// flash not erased
		// save the affected records (blocks)
		memcpy(scratch_page, (uint8_t *) flash_addr, FD_PAGE_SIZE);

		// copy the blocks to the scratch buffer
		byte_p = pData;
		for (i=0; i<FD_BLOCKS_PER_PAGE; i++) {
			if (block_field & (1 << i)) {
				// block belongs to page -> copy
				memcpy(scratch_page+i*FD_BLOCK_SIZE, byte_p, FD_BLOCK_SIZE);
				byte_p += FD_BLOCK_SIZE;
			}
		}

		// erase page
		if (FLASH_erasePage(flash_addr) == HAL_OK) {
			// flash the page
			byte_p = (uint8_t *) flash_addr;
			for (i=0; i<(FD_PAGE_SIZE/FD_FLASH_RECORD); i++) {
				if (FLASH_programDouble( (uint32_t) byte_p,
						*(uint32_t *) (scratch_page+i*FD_FLASH_RECORD),
						*(uint32_t *) (scratch_page+i*FD_FLASH_RECORD+4) )
						!= HAL_OK) {
					retr = SD_ERROR;
					break;
				}
				byte_p += 8;
			}
		} else {
			retr = SD_ERROR;
		}
	}
	return retr;
}
