spyren/Mecrisp-Cube/peripherals/mecrisp-cube-logo.h

/*
 * mecrisp_cube_logo.h
 *
 *  Created on: 18.10.2022
 *      Author: psi
 */

#ifndef MECRISP_CUBE_LOGO_H_
#define MECRISP_CUBE_LOGO_H_

#define mecrisp_cube_logo_width 32
#define mecrisp_cube_logo_height 32
static char mecrisp_cube_logo_bits[] = {
	    0xff, 0xff, 0xff, 0xff, 0xff, 0xff, 0xff, 0xff,
	    0xff, 0xff, 0xff, 0xff, 0xff, 0xff, 0xff, 0xff,
	    0xff, 0xff, 0xff, 0xff, 0x1f, 0xe0, 0x07, 0xf8,
	    0x1f, 0xe0, 0x07, 0xf8, 0x1f, 0xe0, 0x07, 0xf8,
	    0x1f, 0xe0, 0x07, 0xf8, 0x1f, 0xe0, 0x07, 0xf8,
	    0x1f, 0xe0, 0x07, 0xf8, 0x1f, 0xe0, 0x07, 0xf8,
	    0x1f, 0xe0, 0x07, 0xf8, 0xff, 0xff, 0xff, 0xff,
	    0xff, 0xff, 0xff, 0xff, 0xff, 0xff, 0xff, 0xff,
	    0xff, 0xff, 0xff, 0xff, 0xff, 0xff, 0xff, 0xff,
	    0xff, 0xff, 0xff, 0xff, 0x1f, 0xe0, 0x07, 0xf8,
	    0x1f, 0xe0, 0x07, 0xf8, 0x1f, 0xe0, 0x07, 0xf8,
	    0x1f, 0xe0, 0x07, 0xb8, 0x1f, 0xe0, 0x07, 0x80,
	    0x1f, 0xe0, 0x07, 0x80, 0x1f, 0xe0, 0x07, 0xc0,
	    0x1f, 0xe0, 0x07, 0xf0, 0xff, 0xff, 0xff, 0xff,
	    0xff, 0xff, 0xff, 0xff, 0xff, 0xff, 0xff, 0xff,
	    0xff, 0xff, 0xff, 0xff, 0xff, 0xff, 0xff, 0xff
};


#endif /* MECRISP_CUBE_LOGO_H_ */
