spyren/Mecrisp-Cube/Core/Src/gpio.c

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

/* Includes ------------------------------------------------------------------*/
#include "gpio.h"

/*----------------------------------------------------------------------------*/
/* Configure GPIO                                                             */
/*----------------------------------------------------------------------------*/
/* USER CODE BEGIN 1 */
void MX_GPIO_Init(void)
{
  GPIO_InitTypeDef GPIO_InitStruct = {0};

  /* GPIO Ports Clock Enable */
  __HAL_RCC_GPIOC_CLK_ENABLE();
  __HAL_RCC_GPIOB_CLK_ENABLE();
  __HAL_RCC_GPIOA_CLK_ENABLE();
  __HAL_RCC_GPIOD_CLK_ENABLE();

  /*Configure GPIO pin Output Level */
  HAL_GPIO_WritePin(GPIOC, D2_Pin|D4_Pin|D7_Pin|D8_Pin, GPIO_PIN_RESET);

  /*Configure GPIO pin Output Level */
  HAL_GPIO_WritePin(GPIOA, D1_Pin|D0_Pin|D3_Pin
		  |D5_Pin, GPIO_PIN_RESET);


  if (LL_GetPackageType() == LL_UTILS_PACKAGETYPE_QFN48) {
    // QFN48 Package -> Dongle
	// LEDs off
    HAL_GPIO_WritePin(GPIOB, LD2_Pin|LD3_Pin, GPIO_PIN_RESET);
    HAL_GPIO_WritePin(LD1_DONGLE_GPIO_Port, LD1_DONGLE_Pin, GPIO_PIN_RESET);

    // Output level for SPI CS is high
    HAL_GPIO_WritePin(DONGLE_SPI_CS_GPIO_Port, DONGLE_SPI_CS_Pin, GPIO_PIN_SET);
    // Configure GPIO pins :  DONGLE_SPI_CS_Pin
    GPIO_InitStruct.Pin = DONGLE_SPI_CS_Pin;
    GPIO_InitStruct.Mode = GPIO_MODE_OUTPUT_PP;
    GPIO_InitStruct.Pull = GPIO_NOPULL;
    GPIO_InitStruct.Speed = GPIO_SPEED_FREQ_LOW;
    HAL_GPIO_Init(DONGLE_SPI_CS_GPIO_Port, &GPIO_InitStruct);
  } else {
    // Nucleo Board
    /*Configure GPIO pin Output Level */
	// LEDs off
    HAL_GPIO_WritePin(GPIOB, LD2_Pin|LD3_Pin|LD1_Pin, GPIO_PIN_RESET);

    // Output level for SPI CS is high
    HAL_GPIO_WritePin(GPIOA, D10_Pin, GPIO_PIN_SET);
  }

  /*Configure GPIO pins :  D2_Pin D4_Pin D7_Pin D8_Pin */
  GPIO_InitStruct.Pin = D2_Pin|D4_Pin|D7_Pin|D8_Pin;
  GPIO_InitStruct.Mode = GPIO_MODE_OUTPUT_PP;
  GPIO_InitStruct.Pull = GPIO_NOPULL;
  GPIO_InitStruct.Speed = GPIO_SPEED_FREQ_LOW;
  HAL_GPIO_Init(GPIOC, &GPIO_InitStruct);

  /*Configure GPIO pins : D15_Pin D14_Pin */
  GPIO_InitStruct.Pin = D15_Pin|D14_Pin;
  GPIO_InitStruct.Mode = GPIO_MODE_INPUT;
  GPIO_InitStruct.Pull = GPIO_PULLUP;
  HAL_GPIO_Init(GPIOB, &GPIO_InitStruct);

  /*Configure GPIO pins : A0_Pin A1_Pin A5_Pin A4_Pin */
  GPIO_InitStruct.Pin = A0_Pin|A1_Pin|A5_Pin|A4_Pin;
  GPIO_InitStruct.Mode = GPIO_MODE_ANALOG;
  GPIO_InitStruct.Pull = GPIO_NOPULL;
  HAL_GPIO_Init(GPIOC, &GPIO_InitStruct);

  /*Configure GPIO pins : A3_Pin A2_Pin */
  GPIO_InitStruct.Pin = A3_Pin|A2_Pin;
  GPIO_InitStruct.Mode = GPIO_MODE_ANALOG;
  GPIO_InitStruct.Pull = GPIO_NOPULL;
  HAL_GPIO_Init(GPIOA, &GPIO_InitStruct);

  /*Configure GPIO pins : D1_Pin D0_Pin D6_Pin D3_Pin
	                           D5_Pin */
  // D10 is SPI CS for Nucleo
  GPIO_InitStruct.Pin = D1_Pin|D0_Pin|D6_Pin|D3_Pin
		  |D5_Pin|D10_Pin;
  GPIO_InitStruct.Mode = GPIO_MODE_OUTPUT_PP;
  GPIO_InitStruct.Pull = GPIO_NOPULL;
  GPIO_InitStruct.Speed = GPIO_SPEED_FREQ_LOW;
  HAL_GPIO_Init(GPIOA, &GPIO_InitStruct);

//  /*Configure GPIO pins : D10_Pin D13_Pin D12_Pin D11_Pin
//	                           D9_Pin */
//  GPIO_InitStruct.Pin = D10_Pin|D13_Pin|D12_Pin|D11_Pin
//		  |D9_Pin;
//  GPIO_InitStruct.Mode = GPIO_MODE_INPUT;
//  GPIO_InitStruct.Pull = GPIO_PULLUP;
//  HAL_GPIO_Init(GPIOA, &GPIO_InitStruct);

  /*Configure GPIO pins : D9_Pin */
  // D11, D12, D13 belongs to the SPI
  GPIO_InitStruct.Pin = D9_Pin;
  GPIO_InitStruct.Mode = GPIO_MODE_INPUT;
  GPIO_InitStruct.Pull = GPIO_PULLUP;
  HAL_GPIO_Init(GPIOA, &GPIO_InitStruct);

  if (LL_GetPackageType() == LL_UTILS_PACKAGETYPE_QFN48) {
    // QFN48 Package -> Dongle
    /*Configure GPIO pin : B1_Pin */
    GPIO_InitStruct.Pin = B1_DONGLE_Pin;
    GPIO_InitStruct.Mode = GPIO_MODE_INPUT;
    GPIO_InitStruct.Pull = GPIO_PULLUP;
    HAL_GPIO_Init(B1_DONGLE_GPIO_Port, &GPIO_InitStruct);

    /*Configure GPIO pins : DONGLE_SPI_CS_Pin LD2_Pin LD3_Pin */
    GPIO_InitStruct.Pin = DONGLE_SPI_CS_Pin|LD2_Pin|LD3_Pin;
    GPIO_InitStruct.Mode = GPIO_MODE_OUTPUT_PP;
    GPIO_InitStruct.Pull = GPIO_NOPULL;
    GPIO_InitStruct.Speed = GPIO_SPEED_FREQ_LOW;
    HAL_GPIO_Init(GPIOB, &GPIO_InitStruct);

    /*Configure GPIO pins : LD1_Pin */
    GPIO_InitStruct.Pin = LD1_DONGLE_Pin;
    GPIO_InitStruct.Mode = GPIO_MODE_OUTPUT_PP;
    GPIO_InitStruct.Pull = GPIO_NOPULL;
    GPIO_InitStruct.Speed = GPIO_SPEED_FREQ_LOW;
    HAL_GPIO_Init(LD1_DONGLE_GPIO_Port, &GPIO_InitStruct);

  } else {
    // Nucleo Board
    /*Configure GPIO pin : B1_Pin */
    GPIO_InitStruct.Pin = B1_Pin;
    GPIO_InitStruct.Mode = GPIO_MODE_INPUT;
    GPIO_InitStruct.Mode = GPIO_MODE_IT_RISING;
    GPIO_InitStruct.Pull = GPIO_PULLUP;
    HAL_GPIO_Init(B1_GPIO_Port, &GPIO_InitStruct);

    /*Configure GPIO pins : B2_Pin B3_Pin */
    GPIO_InitStruct.Pin = B2_Pin|B3_Pin;
    GPIO_InitStruct.Mode = GPIO_MODE_INPUT;
    GPIO_InitStruct.Pull = GPIO_PULLUP;
    HAL_GPIO_Init(GPIOD, &GPIO_InitStruct);

    /*Configure GPIO pins : LD2_Pin LD3_Pin LD1_Pin */
    GPIO_InitStruct.Pin = LD2_Pin|LD3_Pin|LD1_Pin;
    GPIO_InitStruct.Mode = GPIO_MODE_OUTPUT_PP;
    GPIO_InitStruct.Pull = GPIO_NOPULL;
    GPIO_InitStruct.Speed = GPIO_SPEED_FREQ_LOW;
    HAL_GPIO_Init(GPIOB, &GPIO_InitStruct);
  }

  /* EXTI interrupt init*/
  HAL_NVIC_SetPriority(EXTI4_IRQn, 5, 0);
  HAL_NVIC_EnableIRQ(EXTI4_IRQn);

  HAL_NVIC_SetPriority(EXTI9_5_IRQn, 5, 0);
  HAL_NVIC_EnableIRQ(EXTI9_5_IRQn);

  HAL_NVIC_SetPriority(EXTI15_10_IRQn, 5, 0);
  HAL_NVIC_EnableIRQ(EXTI15_10_IRQn);

}

#if 0
/* USER CODE END 1 */

/** Configure pins as
        * Analog
        * Input
        * Output
        * EVENT_OUT
        * EXTI
*/
void MX_GPIO_Init(void)
{

  GPIO_InitTypeDef GPIO_InitStruct = {0};

  /* GPIO Ports Clock Enable */
  __HAL_RCC_GPIOC_CLK_ENABLE();
  __HAL_RCC_GPIOB_CLK_ENABLE();
  __HAL_RCC_GPIOA_CLK_ENABLE();
  __HAL_RCC_GPIOD_CLK_ENABLE();

  /*Configure GPIO pin Output Level */
  HAL_GPIO_WritePin(DONGLE_SPI_CS_GPIO_Port, DONGLE_SPI_CS_Pin, GPIO_PIN_SET);

  /*Configure GPIO pin Output Level */
  HAL_GPIO_WritePin(GPIOB, LD2_Pin|LD3_Pin|LD1_Pin, GPIO_PIN_RESET);

  /*Configure GPIO pins : PCPin PCPin PCPin */
  GPIO_InitStruct.Pin = D7_Pin|D2_Pin|D4_Pin;
  GPIO_InitStruct.Mode = GPIO_MODE_IT_RISING;
  GPIO_InitStruct.Pull = GPIO_NOPULL;
  HAL_GPIO_Init(GPIOC, &GPIO_InitStruct);

  /*Configure GPIO pin : PtPin */
  GPIO_InitStruct.Pin = D10_Pin;
  GPIO_InitStruct.Mode = GPIO_MODE_IT_RISING;
  GPIO_InitStruct.Pull = GPIO_PULLUP;
  HAL_GPIO_Init(D10_GPIO_Port, &GPIO_InitStruct);

  /*Configure GPIO pins : PCPin PCPin */
  GPIO_InitStruct.Pin = B1_Pin|D8_Pin;
  GPIO_InitStruct.Mode = GPIO_MODE_INPUT;
  GPIO_InitStruct.Pull = GPIO_PULLUP;
  HAL_GPIO_Init(GPIOC, &GPIO_InitStruct);

  /*Configure GPIO pins : PBPin PBPin PBPin PBPin */
  GPIO_InitStruct.Pin = DONGLE_SPI_CS_Pin|LD2_Pin|LD3_Pin|LD1_Pin;
  GPIO_InitStruct.Mode = GPIO_MODE_OUTPUT_PP;
  GPIO_InitStruct.Pull = GPIO_NOPULL;
  GPIO_InitStruct.Speed = GPIO_SPEED_FREQ_LOW;
  HAL_GPIO_Init(GPIOB, &GPIO_InitStruct);

  /*Configure GPIO pins : PDPin PDPin */
  GPIO_InitStruct.Pin = B2_Pin|B3_Pin;
  GPIO_InitStruct.Mode = GPIO_MODE_INPUT;
  GPIO_InitStruct.Pull = GPIO_PULLUP;
  HAL_GPIO_Init(GPIOD, &GPIO_InitStruct);

  /* EXTI interrupt init*/
  HAL_NVIC_SetPriority(EXTI4_IRQn, 5, 0);
  HAL_NVIC_EnableIRQ(EXTI4_IRQn);

  HAL_NVIC_SetPriority(EXTI9_5_IRQn, 5, 0);
  HAL_NVIC_EnableIRQ(EXTI9_5_IRQn);

  HAL_NVIC_SetPriority(EXTI15_10_IRQn, 5, 0);
  HAL_NVIC_EnableIRQ(EXTI15_10_IRQn);

}

/* USER CODE BEGIN 2 */
#endif
/* USER CODE END 2 */
