spyren/Mecrisp-Cube/Core/Src/app_freertos.c

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

/* Includes ------------------------------------------------------------------*/
#include "FreeRTOS.h"
#include "task.h"
#include "main.h"
#include "cmsis_os.h"

/* USER CODE BEGIN Includes */
#include "app_common.h"
#include "app_entry.h"
#include "uart.h"
#include "flash.h"
#include "usb_cdc.h"
#include "bsp.h"
#include "rt_spi.h"
#include "sd.h"
#include "fd.h"
#include "block.h"
#include "app_fatfs.h"
#include "fs.h"
#include "vi.h"
#include "shci.h"
#include "clock.h"
#include "iic.h"
#include "plex.h"
#include "watchdog.h"
#include "myassert.h"
#if OLED == 1
#include "oled.h"
#endif
#if MIP == 1
#include "mip.h"
#endif
#if EPD == 1
#include "epd.h"
#endif
#if QUAD == 1
#include "quad.h"
#endif
#if BUTTON == 1
#include "button.h"
#endif
#include "tiny.h"
#if POWER == 1
#include "power.h"
#endif



/* USER CODE END Includes */

/* Definitions for FORTH_ConThread */
osThreadId_t FORTH_ConThreadHandle;
const osThreadAttr_t FORTH_ConThread_attributes = {
  .name = "FORTH_Console",
  .priority = (osPriority_t) osPriorityNormal,
  .stack_size = 128 * 20
};

/* USER CODE BEGIN FunctionPrototypes */
void Forth(void);
   
/* USER CODE END FunctionPrototypes */

void MainThread(void *argument);

void MX_FREERTOS_Init(void); /* (MISRA C 2004 rule 8.1) */

/**
  * @brief  FreeRTOS initialization
  * @param  None
  * @retval None
  */
void MX_FREERTOS_Init(void) {
  /* USER CODE BEGIN Init */
#if POWER == 1
	POWER_init();
#endif
	WATCHDOG_init();
	BSP_init();
	RTC_init();
	UART_init();
	IIC_init();
	CDC_init();
	FLASH_init();
	RTSPI_init();
	VI_init();
	TINY_init();

  /* USER CODE END Init */

  /* USER CODE BEGIN RTOS_MUTEX */
  /* add mutexes, ... */
  /* USER CODE END RTOS_MUTEX */

  /* USER CODE BEGIN RTOS_SEMAPHORES */
  /* add semaphores, ... */
  /* USER CODE END RTOS_SEMAPHORES */

  /* USER CODE BEGIN RTOS_TIMERS */
  /* start timers, add new ones, ... */
  /* USER CODE END RTOS_TIMERS */

  /* USER CODE BEGIN RTOS_QUEUES */
  /* add queues, ... */
  /* USER CODE END RTOS_QUEUES */

  /* Create the thread(s) */
  /* creation of FORTH_ConThread */
  FORTH_ConThreadHandle = osThreadNew(MainThread, NULL, &FORTH_ConThread_attributes);

  /* USER CODE BEGIN RTOS_THREADS */
  /* add threads, ... */
  /* USER CODE END RTOS_THREADS */

  /* USER CODE BEGIN RTOS_EVENTS */
  /* add events, ... */
  /* USER CODE END RTOS_EVENTS */

}

/* USER CODE BEGIN Header_MainThread */
/**
  * @brief  Function implementing the Main thread.
  * @param  argument: Not used
  * @retval None
  */
/* USER CODE END Header_MainThread */
void MainThread(void *argument)
{
  /* USER CODE BEGIN MainThread */
//	BSP_setSysLED(SYSLED_POWER_ON); // dimmed white LED
	BSP_setLED2(TRUE);
	ASSERT_init();
#if SD_DRIVE == 1
	BLOCK_init();
	SD_init();
#endif
	FD_init();
	FS_init();
#if OLED == 1
	OLED_init();
#endif
#if MIP == 1
	MIP_init();
#endif
#if PLEX == 1
	PLEX_init();
#endif
#if EPD == 1
	EPD_init();
#endif
#if BUTTON == 1
	BUTTON_init();
#endif

	// wait till BLE is ready
	if (osThreadFlagsWait(BLE_IS_READY, osFlagsWaitAny, 2000) == BLE_IS_READY) {
		// sem7 is used by CPU2 to prevent CPU1 from writing/erasing data in Flash memory
		SHCI_C2_SetFlashActivityControl(FLASH_ACTIVITY_CONTROL_SEM7);
//		BSP_clearSysLED(SYSLED_POWER_ON);
		BSP_setLED2(FALSE);
	} else {
		// timeout -> BLE (CPU2) not started, flash operations not possible
//		BSP_clearSysLED(SYSLED_POWER_ON);
//		BSP_setSysLED(SYSLED_ERROR); // dimmed red LED
		BSP_setLED2(FALSE);
		BSP_setLED3(TRUE);
	}


	Forth();

	ASSERT_fatal(0, ASSERT_FORTH_UNEXPECTED_EXIT, 0);

  /* USER CODE END MainThread */
}
