spyren/Mecrisp-Cube/Core/Src/stm32wbxx_hal_msp.c

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

/* Includes ------------------------------------------------------------------*/
#include "main.h"

/* USER CODE BEGIN Includes */
#include "cmsis_os.h"
/* USER CODE END Includes */

/* External functions --------------------------------------------------------*/
/**
  * Initializes the Global MSP.
  */
void HAL_MspInit(void)
{
  /* USER CODE BEGIN MspInit 0 */
  // RTOS SysTick has lowest priority
  HAL_NVIC_SetPriority(SysTick_IRQn, configLIBRARY_LOWEST_INTERRUPT_PRIORITY, 0);

  // CubeMX does not create code for the IPCC interrupt priority
  HAL_NVIC_SetPriority(IPCC_C1_RX_IRQn, configLIBRARY_MAX_SYSCALL_INTERRUPT_PRIORITY + 1, 0);
  HAL_NVIC_SetPriority(IPCC_C1_TX_IRQn, configLIBRARY_MAX_SYSCALL_INTERRUPT_PRIORITY + 1, 0);
  HAL_NVIC_EnableIRQ(IPCC_C1_RX_IRQn);
  HAL_NVIC_EnableIRQ(IPCC_C1_TX_IRQn);

  /* USER CODE END MspInit 0 */

  __HAL_RCC_HSEM_CLK_ENABLE();

  /* System interrupt init*/
  /* PendSV_IRQn interrupt configuration */
  HAL_NVIC_SetPriority(PendSV_IRQn, 15, 0);

  /* Peripheral interrupt init */
  /* FLASH_IRQn interrupt configuration */
  HAL_NVIC_SetPriority(FLASH_IRQn, 5, 0);
  HAL_NVIC_EnableIRQ(FLASH_IRQn);
  /* HSEM_IRQn interrupt configuration */
  HAL_NVIC_SetPriority(HSEM_IRQn, 5, 0);
  HAL_NVIC_EnableIRQ(HSEM_IRQn);

}
