spyren/Mecrisp-Cube/peripherals/sd.h

/*
 * sd.h
 *
 *  Created on: 17.02.2020
 *      Author: psi
 */

#ifndef INC_SD_H_
#define INC_SD_H_

/**
  * @brief  SD status structure definition
  */
enum {
	SD_OK = 0x00,
	MSD_OK = 0x00,
	SD_ERROR = 0x01,
	SD_TIMEOUT
};

typedef struct {
	uint8_t  Reserved1:2;               /* Reserved */
	uint16_t DeviceSize:12;             /* Device Size */
	uint8_t  MaxRdCurrentVDDMin:3;      /* Max. read current @ VDD min */
	uint8_t  MaxRdCurrentVDDMax:3;      /* Max. read current @ VDD max */
	uint8_t  MaxWrCurrentVDDMin:3;      /* Max. write current @ VDD min */
	uint8_t  MaxWrCurrentVDDMax:3;      /* Max. write current @ VDD max */
	uint8_t  DeviceSizeMul:3;           /* Device size multiplier */
} struct_v1;


typedef struct {
	uint8_t  Reserved1:6;               /* Reserved */
	uint32_t DeviceSize:22;             /* Device Size */
	uint8_t  Reserved2:1;               /* Reserved */
} struct_v2;

/**
  * @brief  Card Specific Data: CSD Register
  */
typedef struct {
	/* Header part */
	uint8_t  CSDStruct:2;            /* CSD structure */
	uint8_t  Reserved1:6;            /* Reserved */
	uint8_t  TAAC:8;                 /* Data read access-time 1 */
	uint8_t  NSAC:8;                 /* Data read access-time 2 in CLK cycles */
	uint8_t  MaxBusClkFrec:8;        /* Max. bus clock frequency */
	uint16_t CardComdClasses:12;      /* Card command classes */
	uint8_t  RdBlockLen:4;           /* Max. read data block length */
	uint8_t  PartBlockRead:1;        /* Partial blocks for read allowed */
	uint8_t  WrBlockMisalign:1;      /* Write block misalignment */
	uint8_t  RdBlockMisalign:1;      /* Read block misalignment */
	uint8_t  DSRImpl:1;              /* DSR implemented */

	/* v1 or v2 struct */
	union csd_version {
		struct_v1 v1;
		struct_v2 v2;
	} version;

	uint8_t  EraseSingleBlockEnable:1;  /* Erase single block enable */
	uint8_t  EraseSectorSize:7;         /* Erase group size multiplier */
	uint8_t  WrProtectGrSize:7;         /* Write protect group size */
	uint8_t  WrProtectGrEnable:1;       /* Write protect group enable */
	uint8_t  Reserved2:2;               /* Reserved */
	uint8_t  WrSpeedFact:3;             /* Write speed factor */
	uint8_t  MaxWrBlockLen:4;           /* Max. write data block length */
	uint8_t  WriteBlockPartial:1;       /* Partial blocks for write allowed */
	uint8_t  Reserved3:5;               /* Reserved */
	uint8_t  FileFormatGrouop:1;        /* File format group */
	uint8_t  CopyFlag:1;                /* Copy flag (OTP) */
	uint8_t  PermWrProtect:1;           /* Permanent write protection */
	uint8_t  TempWrProtect:1;           /* Temporary write protection */
	uint8_t  FileFormat:2;              /* File Format */
	uint8_t  Reserved4:2;               /* Reserved */
	uint8_t  crc:7;                     /* Reserved */
	uint8_t  Reserved5:1;               /* always 1*/

} SD_CSD;

/**
  * @brief  Card Identification Data: CID Register
  */
typedef struct {
	__IO uint8_t  ManufacturerID;       /* ManufacturerID */
	__IO uint16_t OEM_AppliID;          /* OEM/Application ID */
	__IO uint32_t ProdName1;            /* Product Name part1 */
	__IO uint8_t  ProdName2;            /* Product Name part2*/
	__IO uint8_t  ProdRev;              /* Product Revision */
	__IO uint32_t ProdSN;               /* Product Serial Number */
	__IO uint8_t  Reserved1;            /* Reserved1 */
	__IO uint16_t ManufactDate;         /* Manufacturing Date */
	__IO uint8_t  CID_CRC;              /* CID CRC */
	__IO uint8_t  Reserved2;            /* always 1 */
} SD_CID;

/**
  * @brief SD Card information
  */
typedef struct {
	SD_CSD Csd;
	SD_CID Cid;
	uint64_t CardCapacity;              /*!< Card Capacity */
	uint32_t CardBlockSize;             /*!< Card Block Size */
	uint32_t LogBlockNbr;               /*!< Specifies the Card logical Capacity in blocks   */
	uint32_t LogBlockSize;              /*!< Specifies logical block size in bytes           */
} SD_CardInfo;


/**
  * @brief  Block Size
  */
#define SD_BLOCK_SIZE    0x200

/**
  * @brief  SD detection on its memory slot
  */
#define SD_PRESENT               ((uint8_t)0x01)
#define SD_NOT_PRESENT           ((uint8_t)0x00)

#define SD_DATATIMEOUT           ((uint32_t)100000000)

/**
  * @brief SD Card information structure
  */
#define SD_CardInfo SD_CardInfo

void    SD_init(void);
void    SD_getSize(void);
int 	SD_getBlocks(void);
void    SD_emptyBuffers(void);
void    SD_updateBlock(void);
uint8_t *SD_getBlock(int block_number);
uint8_t *SD_assignBlock(int block_number);
void    SD_saveBuffers(void);
void    SD_flushBuffers(void);

uint8_t SD_ReadBlocks(uint8_t *pData, uint32_t ReadAddr, uint32_t NumOfBlocks);
uint8_t SD_WriteBlocks(uint8_t *pData, uint32_t WriteAddr, uint32_t NumOfBlocks);
uint8_t SD_Erase(uint32_t StartAddr, uint32_t EndAddr);
uint8_t SD_GetCardState(void);
uint8_t SD_GetCardInfo(SD_CardInfo *pCardInfo);

#endif /* INC_SD_H_ */
