spyren/Mecrisp-Cube/STM32_WPAN/App/dis_app.h

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

/* Define to prevent recursive inclusion -------------------------------------*/
#ifndef DIS_APP_H
#define DIS_APP_H

#ifdef __cplusplus
extern "C" {
#endif

/* Includes ------------------------------------------------------------------*/

/* USER CODE BEGIN Includes */
#include "app_conf.h"
/* USER CODE END Includes */

/* Exported types ------------------------------------------------------------*/
/* Exported constants --------------------------------------------------------*/
/* External variables --------------------------------------------------------*/
/* Exported macros -----------------------------------------------------------*/
#define DISAPP_MANUFACTURER_NAME              "STM"
#define DISAPP_MODEL_NUMBER                   "4502-1.0"
#define DISAPP_SERIAL_NUMBER                  "1.0"
#define DISAPP_HARDWARE_REVISION_NUMBER       "1.0"
#define DISAPP_FIRMWARE_REVISION_NUMBER       "1.0"
#define DISAPP_SOFTWARE_REVISION_NUMBER       "1.0"
#define DISAPP_OUI                            0x123456
#define DISAPP_MANUFACTURER_ID                0x9ABCDE
/* USER CODE BEGIN EM */
#undef DISAPP_MANUFACTURER_NAME
#undef DISAPP_MODEL_NUMBER
#undef DISAPP_SERIAL_NUMBER
#undef DISAPP_FIRMWARE_REVISION_NUMBER
#undef DISAPP_SOFTWARE_REVISION_NUMBER
#define DISAPP_MANUFACTURER_NAME              "spyr.ch"
#define DISAPP_MODEL_NUMBER                   "Mecrisp-Cube-WB55nucleo"
#define DISAPP_SERIAL_NUMBER                  "1"
#define DISAPP_FIRMWARE_REVISION_NUMBER       "1.17.3"
#define DISAPP_SOFTWARE_REVISION_NUMBER       MECRISP_CUBE_TAG

/* USER CODE END EM */

/* Exported functions ------------------------------------------------------- */
void DISAPP_Init(void);
#ifdef __cplusplus
}
#endif

#endif /*DIS_APP_H */
