spyren/Mecrisp-Cube/peripherals/bsp.h

/**
 *  @brief
 *      Board Support Package.
 *
 *      LEDs and switches.
 *  @file
 *      bsp.h
 *  @author
 *      Peter Schmid, peter@spyr.ch
 *  @date
 *      2020-03-26
 *  @remark
 *      Language: C, STM32CubeIDE GCC
 *  @copyright
 *      Peter Schmid, Switzerland
 *
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
 *      You should have received a copy of the GNU General Public License
 *      along with Mecrsip-Cube. If not, see http://www.gnu.org/licenses/.
 */



#ifndef INC_BSP_H_
#define INC_BSP_H_

typedef enum {
	SYSLED_ACTIVATE 			= 1 << 0,
	SYSLED_DISK_READ_OPERATION 	= 1 << 1,
	SYSLED_DISK_WRITE_OPERATION = 1 << 2,
	SYSLED_CHARGING 			= 1 << 3,
	SYSLED_FULLY_CHARGED 		= 1 << 4,
	SYSLED_BLE_CONNECTED 		= 1 << 5,
	SYSLED_POWER_ON 		    = 1 << 6,
	SYSLED_ERROR	      	    = 1 << 7,
} BSP_sysled_t;

void BSP_init(void);

void BSP_setLED1(int state);
int BSP_getLED1(void);
void BSP_setLED2(int state);
int BSP_getLED2(void);
void BSP_setLED3(int state);
int BSP_getLED3(void);
int BSP_getSwitch1(void);
int BSP_getSwitch2(void);
int BSP_getSwitch3(void);
void BSP_setDigitalPort(int state);
int BSP_getDigitalPort(void);
void BSP_setDigitalPin(int pin_number, int state);
int BSP_getDigitalPin(int pin_number);
int BSP_getAnalogPin(int pin_number);
int BSP_getVref(void);
int BSP_getVbat(void);
int BSP_getCpuTemperature(void);
void BSP_setPwmPin(int pin_number, int value);
void BSP_setPwmPrescale(uint16_t value);
void BSP_TIM2_PeriodElapsedCallback(void);
void BSP_setPrescaleICOC(uint32_t prescale);
void BSP_setPeriodICOC(uint32_t period);
void BSP_setCounterICOC(uint32_t count);
uint32_t BSP_getCounterICOC(void);
void BSP_startPeriodICOC(void);
void BSP_stopPeriodICOC(void);
void BSP_setModeOC(int pin_number, uint32_t mode);
void BSP_startOC(int pin_number, uint32_t pulse);
void BSP_stopOC(int pin_number);
void BSP_startIC(uint32_t mode);
void BSP_stopIC(void);
void BSP_waitPeriod(void);
uint32_t BSP_waitIC(uint32_t timeout);
void BSP_waitOC(int pin_number);

void BSP_neopixelDataTx(GPIO_TypeDef* GPIOx, uint16_t GPIO_Pin, uint32_t GRBx);
void BSP_neopixelBufferTx(GPIO_TypeDef* GPIOx, uint16_t GPIO_Pin, uint32_t *buffer, uint32_t len);
void BSP_setNeoPixel(uint32_t rgb);
int BSP_getNeoPixel(void);
void BSP_setNeoPixels(uint32_t *buffer, uint32_t len);

void BSP_setSysLED(BSP_sysled_t status);
void BSP_clearSysLED(BSP_sysled_t status);


#endif /* INC_BSP_H_ */
