spyren/Mecrisp-Cube/peripherals/spyr.h

/*
 * spyr.h
 *
 *  Created on: 18.10.2022
 *      Author: psi
 */

#ifndef SPYR_H_
#define SPYR_H_

#define spyr_width 64
#define spyr_height 47
static char spyr_bits[] = {
  0x01, 0x00, 0x00, 0x00, 0x00, 0x00, 0x00, 0x00, 0x03, 0x00, 0x00, 0x04,
  0x00, 0x00, 0x00, 0x00, 0x06, 0x00, 0x00, 0x0C, 0x00, 0x00, 0x00, 0x00,
  0x0E, 0x00, 0x00, 0x08, 0x00, 0x00, 0x00, 0x00, 0x1C, 0x00, 0x00, 0x08,
  0x01, 0x00, 0x00, 0x00, 0x3C, 0x00, 0x00, 0x88, 0x01, 0x00, 0x00, 0x00,
  0x7C, 0x00, 0x00, 0x98, 0x01, 0x00, 0x00, 0x00, 0xF8, 0x00, 0x00, 0x98,
  0x01, 0x00, 0x00, 0x00, 0xF8, 0x01, 0x00, 0xD8, 0x01, 0x00, 0x00, 0x00,
  0xF0, 0x03, 0x00, 0xF8, 0x01, 0x00, 0x00, 0x00, 0xF0, 0x07, 0x00, 0xF8,
  0x01, 0x00, 0x00, 0x00, 0xE0, 0x0F, 0x00, 0xF8, 0x01, 0x00, 0x00, 0x00,
  0xE0, 0x1F, 0x00, 0xF8, 0x01, 0x00, 0x00, 0x00, 0xC0, 0x3F, 0x00, 0xF8,
  0x00, 0x00, 0x00, 0x00, 0x80, 0x7F, 0x00, 0xF8, 0x00, 0x00, 0x00, 0x00,
  0x80, 0xFF, 0x00, 0xF8, 0x00, 0x00, 0x00, 0x00, 0x00, 0xFF, 0x01, 0xFC,
  0x00, 0x00, 0x00, 0x00, 0x00, 0xFF, 0x03, 0xFC, 0x00, 0x00, 0x00, 0x00,
  0x00, 0xFE, 0x07, 0xFC, 0x01, 0x00, 0x00, 0x00, 0x00, 0xFC, 0x0F, 0xFC,
  0x01, 0x00, 0x00, 0x00, 0x00, 0xF8, 0x1F, 0xFE, 0x01, 0x00, 0x00, 0x00,
  0x00, 0xF8, 0xFF, 0xFF, 0x01, 0x00, 0x00, 0x00, 0x00, 0xF0, 0xFF, 0xFF,
  0x03, 0x00, 0x00, 0x00, 0x00, 0xE0, 0xFF, 0xFF, 0x03, 0x00, 0x00, 0x00,
  0x00, 0xE0, 0xFF, 0xFF, 0x03, 0x00, 0x00, 0x00, 0x00, 0xC0, 0xFF, 0xFF,
  0x03, 0x00, 0x00, 0x00, 0x00, 0x80, 0xFF, 0xFF, 0x03, 0x00, 0x00, 0x00,
  0x00, 0x00, 0xFF, 0xFF, 0x07, 0x00, 0x00, 0x00, 0x00, 0x00, 0xFF, 0xFF,
  0x07, 0x00, 0x00, 0x00, 0x00, 0x00, 0xFE, 0xFF, 0x0F, 0x00, 0x00, 0x00,
  0x00, 0x00, 0xFC, 0xFF, 0x1F, 0x00, 0x00, 0x00, 0x00, 0x00, 0xF8, 0xFF,
  0x3F, 0x00, 0x00, 0x00, 0x00, 0x00, 0xE0, 0xFF, 0xFF, 0x00, 0x00, 0x00,
  0x00, 0x00, 0xC0, 0xFF, 0xFF, 0x03, 0x00, 0x00, 0x00, 0x00, 0x00, 0xFE,
  0xFF, 0x1F, 0x00, 0x00, 0x00, 0x00, 0x00, 0xFE, 0xFF, 0x7F, 0x00, 0x00,
  0x00, 0x00, 0x00, 0xFC, 0xFF, 0xFF, 0x01, 0x00, 0x00, 0x00, 0x00, 0xFC,
  0xFF, 0xFF, 0x0F, 0x00, 0x00, 0x00, 0x00, 0xFC, 0xFF, 0xFF, 0x1F, 0x00,
  0x00, 0x00, 0x00, 0xFC, 0xFF, 0xFF, 0xFF, 0x00, 0x00, 0x00, 0x00, 0xF8,
  0xFF, 0xFF, 0xFF, 0x07, 0x00, 0x00, 0x00, 0xF8, 0xF8, 0xFF, 0xFF, 0x3F,
  0x00, 0x00, 0x00, 0x70, 0xF0, 0xFF, 0xFF, 0xFF, 0x00, 0x00, 0x00, 0x40,
  0xC0, 0xFF, 0xFF, 0xFF, 0x00, 0x00, 0x00, 0x00, 0x00, 0xFE, 0xFF, 0x7F,
  0x00, 0x00, 0x00, 0x00, 0x00, 0xE0, 0xFF, 0x3F, 0x00, 0x00, 0x00, 0x00,
  0x00, 0x00, 0xFE, 0x07, };


#endif /* SPYR_H_ */
