spyren/Mecrisp-Cube/STM32_WPAN/App/crs_app.h

/**
  ******************************************************************************
  * @file    crs_app.h
  * @author  MCD Application Team
  * @brief   Header for crs_app.c module
  ******************************************************************************
  * @attention
 *
 * <h2><center>&copy; Copyright (c) 2019 STMicroelectronics.
 * All rights reserved.</center></h2>
 *
 * This software component is licensed by ST under Ultimate Liberty license
 * SLA0044, the "License"; You may not use this file except in compliance with
 * the License. You may obtain a copy of the License at:
 *                             www.st.com/SLA0044
 *
 ******************************************************************************
 */


/* Define to prevent recursive inclusion -------------------------------------*/
#ifndef __CRS_APP_H
#define __CRS_APP_H

#ifdef __cplusplus
extern "C" 
{
#endif

/* Includes ------------------------------------------------------------------*/
/* Exported types ------------------------------------------------------------*/
/* Exported constants --------------------------------------------------------*/
/* External variables --------------------------------------------------------*/
extern osThreadId_t CRS_ThreadId;

/* Exported macros -----------------------------------------------------------*/
#define CRSAPP_CONNECTED	1

/* Exported functions ------------------------------------------------------- */
void CRSAPP_Init( void );


#ifdef __cplusplus
}
#endif

#endif /*__CRS_APP_H */

/************************ (C) COPYRIGHT STMicroelectronics *****END OF FILE****/
