spyren/Mecrisp-Cube/(commit log)

2020-02-21 Skeleton for uart
2020-03-02 CMSIS-RTOS added. Not working yet.
    [app_freertos.c, flash.c, flash.h, main.c, stm32wbxx_hal_msp.c, stm32wbxx_it.c]
2020-03-04 terminal.s s used to call UART C module.
2020-03-26 Board Support Package added.
2020-03-26 Pullups for the switches.
2020-03-27 HAL_UART_Receive_IT busy -> try again in thread.
2020-03-27 FLASH programming interrupt driven and RTOS aware.
2020-03-28 Improved uart module. More return value checks.
2020-04-02 push/pop r0-r3 for the functions in the assembler API.
2020-04-04 Data stack for threads.
2020-04-12 ADC addition to ioc.
2020-04-13 Working ADC.
2020-04-13 Debug trace SWO printf.
2020-04-16 First attempt for BLE STM cable replacement service
    [app_ble.c, dis_app.h]
2020-04-21 Automatic USB-CDC/UART redirection.
2020-04-23 Default terminal depends on switch1/switch2 on reset.
2020-05-09 Do not allow CPU2 to disable the HSI48 oscillator.
    [app_ble.c, main.c]
2020-05-09 Heartrate depends on analog pin 0.
2020-05-10 Pullup for UART Rx.
2020-05-12 Automatic detection of dongle device.
2020-05-18 Blue LED on BLE connection.
2020-05-20 Green LED on USB connection. Prepare for Tag v1.1.0
2020-05-20 UART configuration at runtime.
2020-05-29 PWM working on D3, D6, and D9.
2020-06-03 SPI initialisation.
2020-06-07 Module spi added.
2020-06-14 Size calculation for SD cards > 2GiB corrected.
    [sd.c, sd.h]
2020-07-17 psp and tos as parameter. include still not working
    [fs.c, fs.h]
2020-08-04 evaluate documentation. include still not working
    [fs.c]
2020-08-28 mount/umount added
2020-08-29 Nasty error in FS_include() fixed.
    [fs.c]
2020-09-07 USB CDC is working again. BLE DIS not working, BLE CRS buffer overflow.
    [app_conf.h, app_freertos.c, dis_app.h, hrs_app.c, main.c]
2020-09-07 spi.c renamde to sd_spi.c.
2020-09-08 Init dongle spi cs to high.
2020-10-10 Increased stack size for Forth thread.
2020-10-11 Sample file system for an SD card.
2020-10-14 Memory layout changed. vi in the release bin is not working.
    [app_conf.h, fs.c, main.c]
2020-10-22 HRS working again. vi special keys in the release bin is not working.
    [app_conf.h, app_freertos.c, hrs_app.c]
2020-10-25 USB peripheral initilization after RTOS configuration. Pullups for Dongle UART. Prepare for Tag v1.3.5.
2020-11-01 SD and Flash Drives have their own drivers.
2020-12-05 STM32Cube FW_WB V1.10.0
2020-12-23 Use osDelay(1) for pause
    For backward compatibility.
    pause calls osDelay(1) and gives other threads a chance.
2020-12-23 RTC Wakup
    Not working yet, the wakeup counter does not start.
    [MecrispCube.ioc, app_conf.h, app_freertos.c, clock.c, clock.h, main.c, rtc.c]
2020-12-29 CubeMX for EXTI and I2C
2021-01-01 check the I2C interface
2021-01-01 Add I2C mode
2021-01-05 Use DMA for I2C communication
2021-01-08 Remove interrupts from Forth
    CubeMX C rotines are responsible for interrupt handling.
2021-01-14 Higher priority for CDC thread.
2021-02-12 Correct big font wrapping.
    [oled.c]
2021-02-24 Reset ICPP on startup Wait till HSI48 is ready
    [main.c]
2021-05-24 Ubpdate to STM32Cube FW_WB V1.11.1 (CubeMX generated code).
    not working yet.
    [MecrispCube.ioc, app_conf.h, app_freertos.c, hw_conf.h]
2021-05-24 Update STM32_WPAN/App/app_ble.c to STM32Cube FW_WB V1.11.1
    Not working, there are even compiling errors!
    [app_ble.c]
2021-05-24 Add driver for Plex and Neopixel Wings
2021-05-27 BLE advertising is not working
    [app_ble.c]
2021-05-30 Advertise only HRS Replace THREAD by PROCESS in generated routines Add RTC_WKUP_IRQHandler for HW_TS
    [app_ble.c, app_freertos.c, dis_app.h, hrs_app.c, stm32wbxx_it.c]
2021-12-23 Restructure directories
    The peripheral drivers are moved from Forth/Src and Forth/Inc to peripherals.
2022-01-02 Add asserts for failed RTOS ressources creation
    ^C and BREAK asserts for console threads.
    [app_freertos.c, block.c, clock.c, fd.c, flash.c, fs.c, iic.c, main.c]
2022-05-13 Change thread names
    The thread names are more consistent.
    Add Watchdog event FreeRTOS.
2022-05-15 a First draft for MIP (not working)
    [app_conf.h, app_freertos.c, mip.c, mip.h, oled.h, plex.c, sd_spi.c]
2022-08-05 Update to STM32CubeWB 1.14.1
2022-08-20 Use board type to select GPIO for SD
2022-08-21 Change NeoPixel from D6 to D8
    Switch3 on reset ignores /etc/rc.local.
    [bsp.c, crs_app.c, fs.c, gpio.c, uart.c]
2022-08-21 Distinguish between SD CS GPIO pin between Nucleo and Dongle
2022-10-19 Change i2c to fast mode
2022-11-18 Synchronize with branch WB5M
    SD not working. CS?
    [app_freertos.c, bsp.c, bsp.h, fpu.c, fs.c, iic.c, iic.h, mip.c]
2022-11-23 Correct errors in plex and oled
    [oled.c, plex.c]
2022-11-29 Harmonize Dongle and Nucleo
    LED2 is power on LED
    UART Rx with pullup
    D6 is Neopixel on Dongle
2024-02-03 Fix large fonts for OLED
    [mecrisp-cube-logo.h, oled.c]
2024-02-04 Add some sample programs
2024-03-06 Replace STM USB middleware by tinyUSB
    [app_ble.c, app_conf.h, app_freertos.c, board.c, board.h, family.c, main.c, msc_disk.c]
2024-03-06 Fix board defines
2024-05-31 Implement button
    There is a problem with the linker
    [app_conf.h, app_freertos.c, bsp.c, button.c, button.h, main.h, stm32wbxx_it.c]
2024-06-04 Add null device
2024-06-07 Create null device
2024-06-17 Update button overlay
2024-06-20 Add images for buttons
2024-06-20 Implement first draft for on off button
2024-06-22 Add diode image
2024-06-22 Add schematic image
2024-06-23 Prepare for LPM
    Not fully tested, OLED has problems in release configuration.
    [app_conf.h, bsp.c, button.c, family.c, iic.c, main.c, rt_spi.c, tiny.c]
2024-06-25 Add kicad project
    [4TH_calculator.kicad_pcb, 4TH_calculator.kicad_sch, kicad.kicad_pcb, kicad.kicad_sch]
2024-06-26 Switch off SYSLED
2024-06-26 Fix float is always decimal
    [button.c]
2024-06-27 Use task critical for flash operations
    [4TH_calculator.kicad_sch]
2024-06-29 Wait for button event
2024-06-30 Wait for button release
2025-01-05 Combine button matrix with button descrete
2025-01-11 Remove mouse inserts
