spyren/Mecrisp-Cube/(notices)

Notices in the files:
Core/Src/stm32wbxx_hal_msp.c:
© Copyright (c) 2020 STMicroelectronics.
All rights reserved.
This software component is licensed by ST under BSD 3-Clause license,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
Core/Src/app_debug.c:
Copyright (c) 2020-2021 STMicroelectronics.
This software is licensed under terms that can be found in the LICENSE file
Core/Src/gpio.c:
Copyright (c) 2022 STMicroelectronics.
STM32_WPAN/App/app_ble.c:
© Copyright (c) 2021 STMicroelectronics.
